akornsys-rdi/high-torque-servo-arm/3d/hand-inmoov/Index3.stl

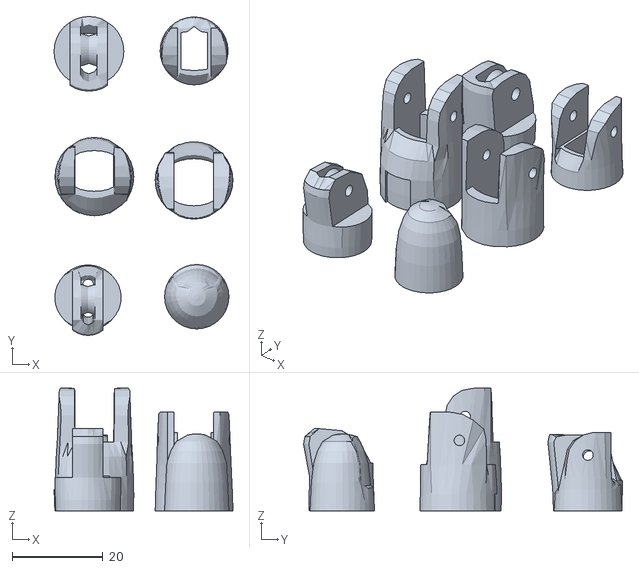
[picture p1: CAD file, 2020-02-25]
3d/hand-inmoov/Index3.stl
39.4 x 70.2 x 27.0
