akornsys-rdi/high-torque-servo-arm/3d/joint_forearm.stl

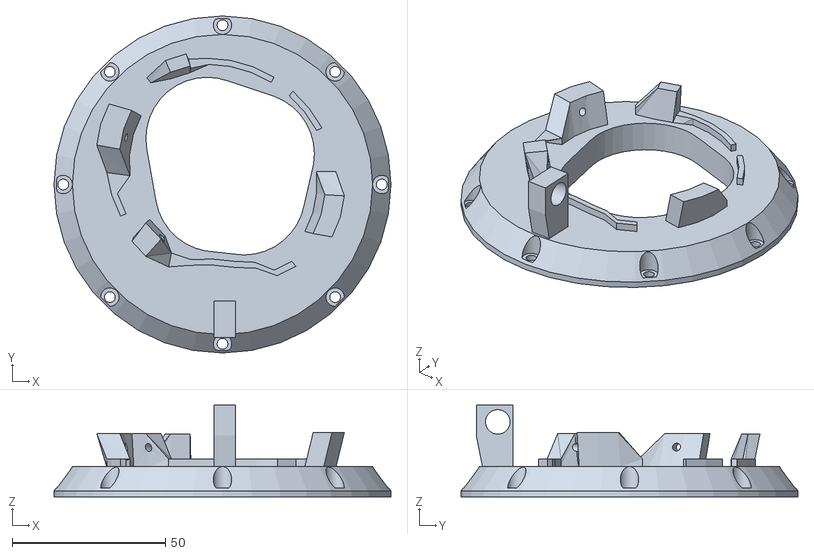
[picture p2: CAD file, 2020-02-25]
3d/joint_forearm.stl
110.0 x 110.0 x 30.0
