akornsys-rdi/high-torque-servo-arm/3d/hand-inmoov/robpart4V3.stl

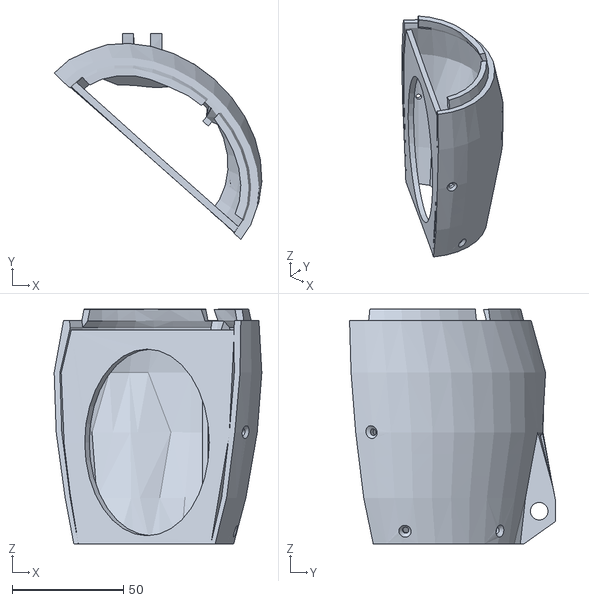
[picture p3: CAD file, 2020-02-25]
3d/hand-inmoov/robpart4V3.stl
93.5 x 92.7 x 105.8
