akornsys-rdi/high-torque-servo-arm/3d/hand-inmoov/robpart2V3.stl

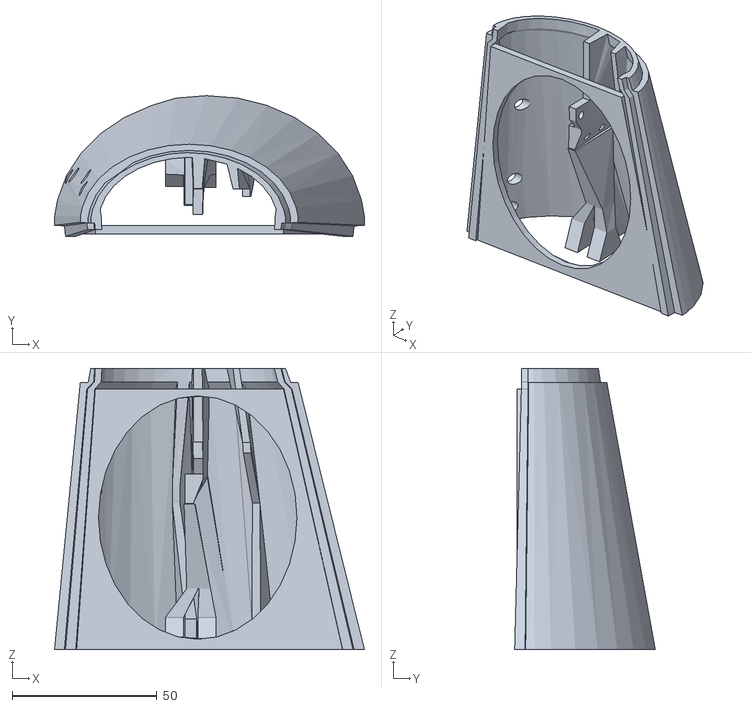
[picture p4: CAD file, 2020-02-25]
3d/hand-inmoov/robpart2V3.stl
107.2 x 48.7 x 97.3
