akornsys-rdi/high-torque-servo-arm/3d/hand-inmoov/WristlargeV4.stl

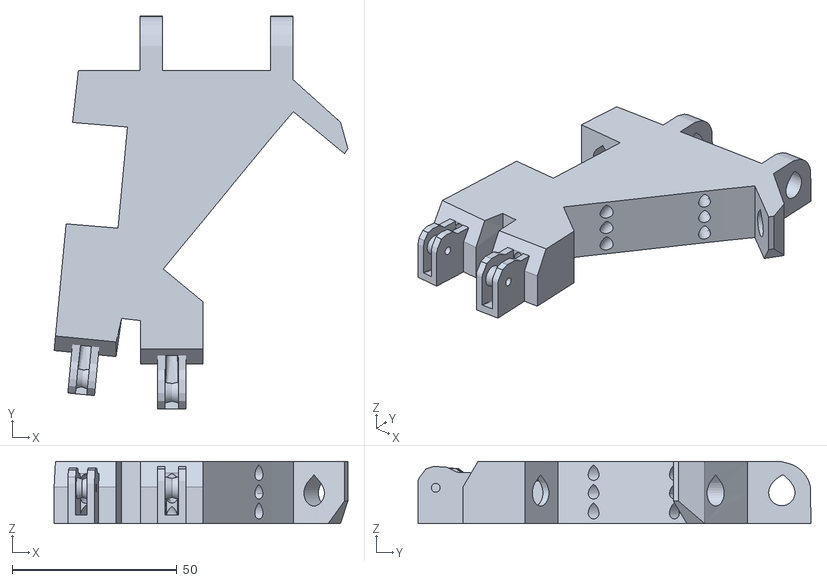
[picture p5: CAD file, 2020-02-25]
3d/hand-inmoov/WristlargeV4.stl
89.2 x 119.4 x 18.9
