akornsys-rdi/high-torque-servo-arm/3d/hand-inmoov/Majeure3.stl

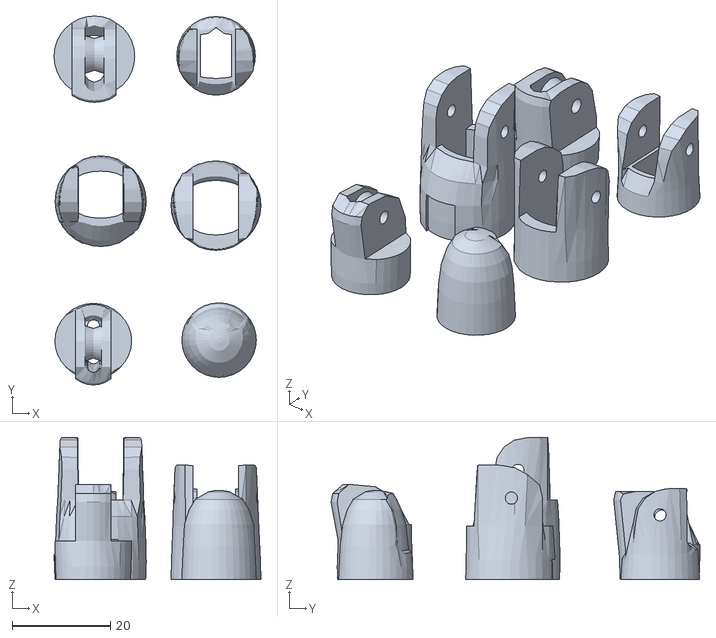
[picture p6: CAD file, 2020-02-25]
3d/hand-inmoov/Majeure3.stl
42.2 x 75.2 x 29.0
