akornsys-rdi/high-torque-servo-arm/3d/hand-inmoov/robpart3V3.stl

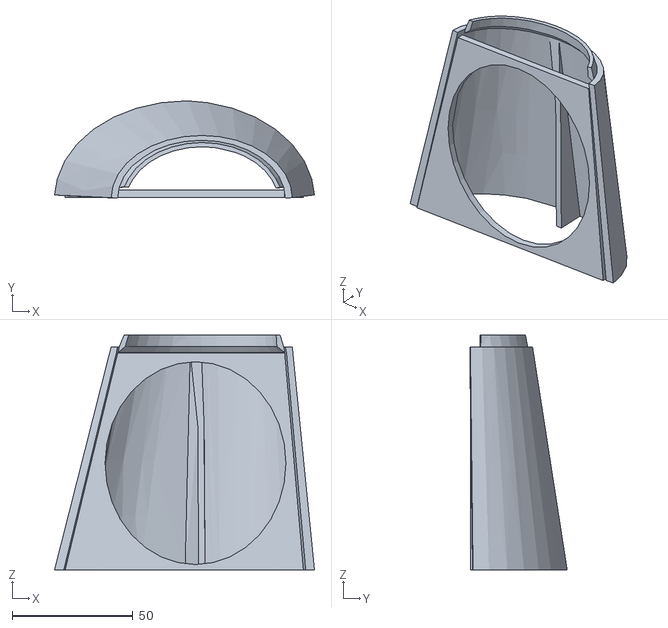
[picture p7: CAD file, 2020-02-25]
3d/hand-inmoov/robpart3V3.stl
107.8 x 40.4 x 97.3
