akornsys-rdi/high-torque-servo-arm/3d/hand-inmoov/ringfinger3.stl

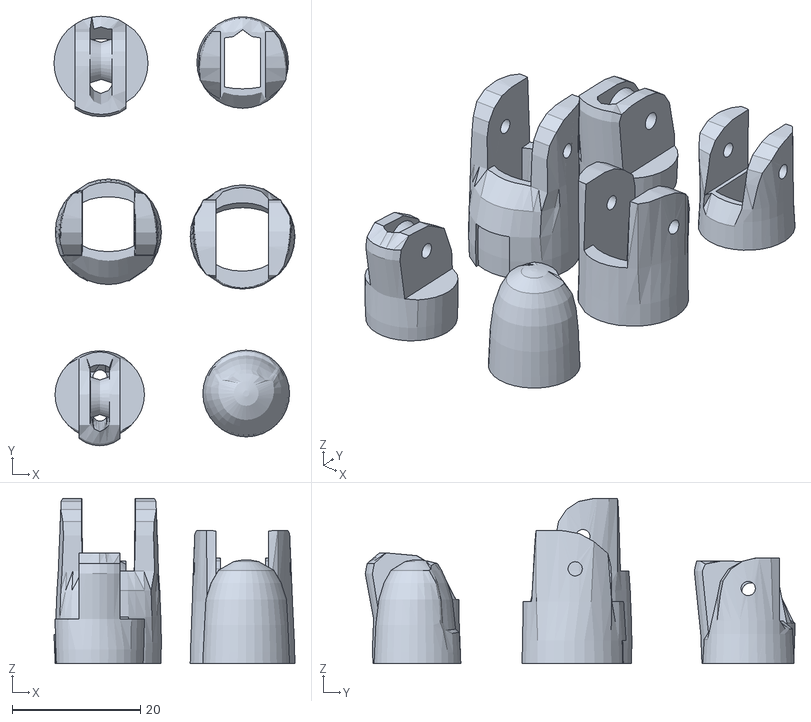
[picture p8: CAD file, 2020-02-25]
3d/hand-inmoov/ringfinger3.stl
37.6 x 67.0 x 25.8
