akornsys-rdi/high-torque-servo-arm/3d/hand-inmoov/elbow-axis-small.stl

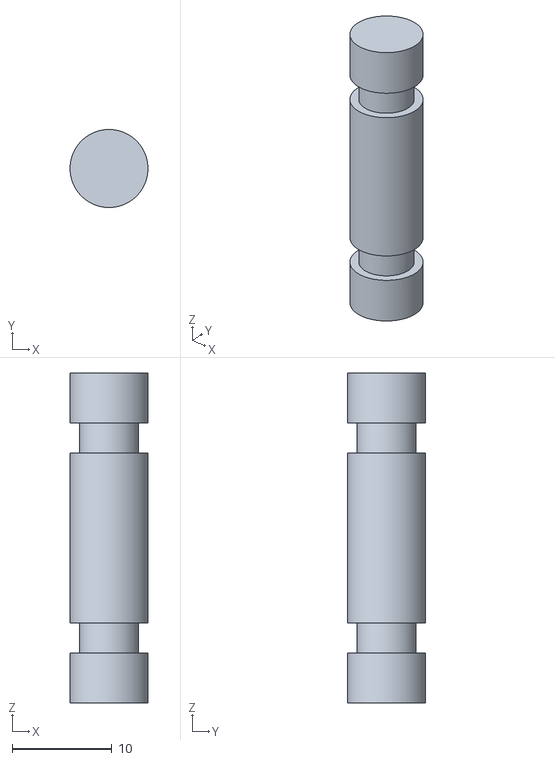
[picture p9: CAD file, 2020-02-25]
3d/hand-inmoov/elbow-axis-small.stl
7.80 x 7.80 x 33.0
