akornsys-rdi/high-torque-servo-arm/3d/hand-inmoov/elbow-axis-clip.stl

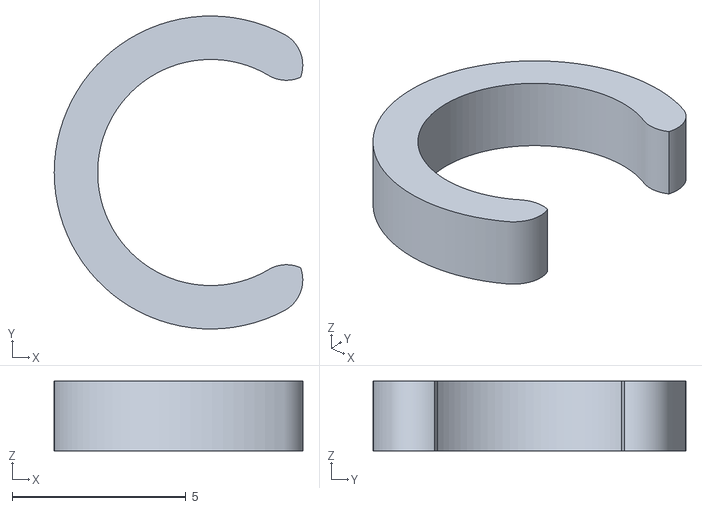
[picture p10: CAD file, 2020-02-25]
3d/hand-inmoov/elbow-axis-clip.stl
7.15 x 9.00 x 2.00
