akornsys-rdi/high-torque-servo-arm/3d/hand-inmoov/WristsmallV3.stl

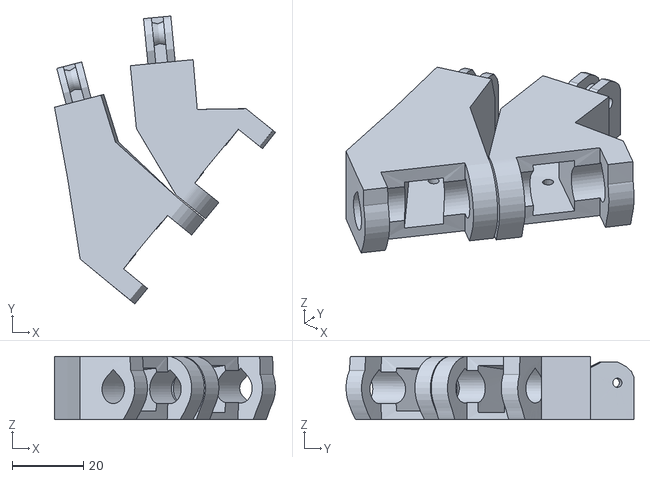
[picture p11: CAD file, 2020-02-25]
3d/hand-inmoov/WristsmallV3.stl
62.0 x 80.8 x 17.7
