akornsys-rdi/high-torque-servo-arm/3d/hand-inmoov/thumb5.stl

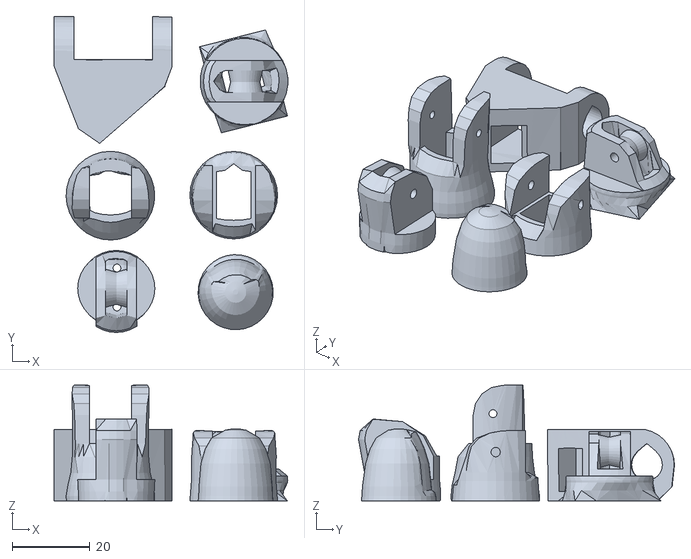
[picture p12: CAD file, 2020-02-25]
3d/hand-inmoov/thumb5.stl
60.1 x 81.2 x 29.8
