akornsys-rdi/high-torque-servo-arm/3d/hand-inmoov/robpart5V3.stl

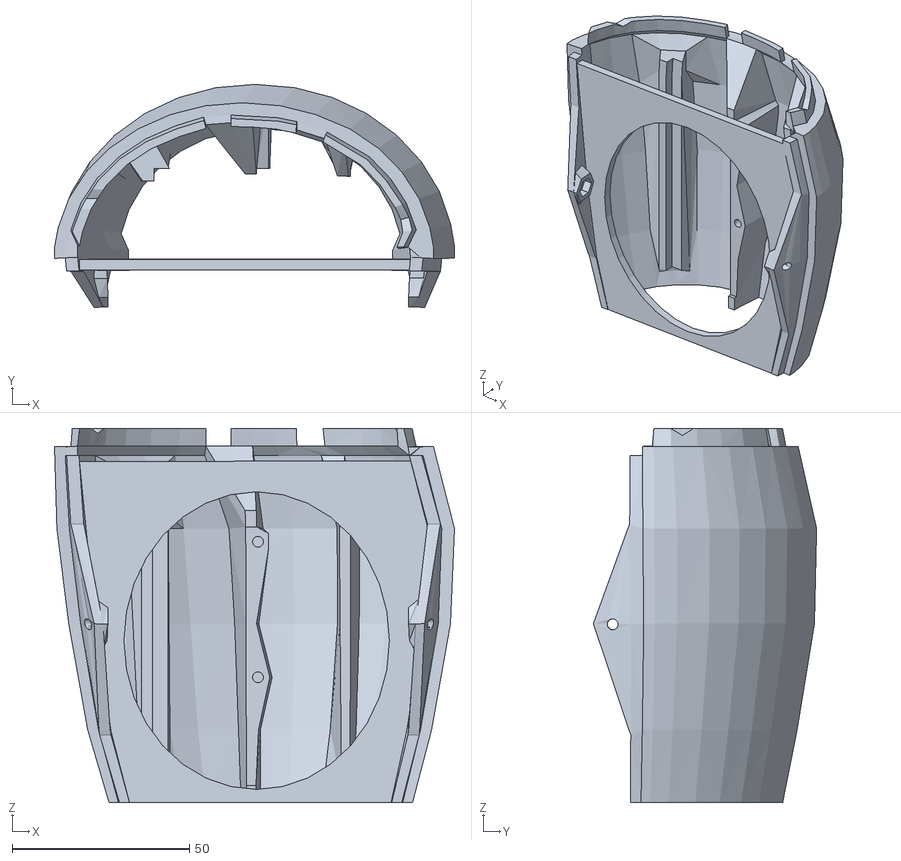
[picture p13: CAD file, 2020-02-25]
3d/hand-inmoov/robpart5V3.stl
113.0 x 63.1 x 105.7
