akornsys-rdi/high-torque-servo-arm/3d/hand-inmoov/robpart1V2.stl

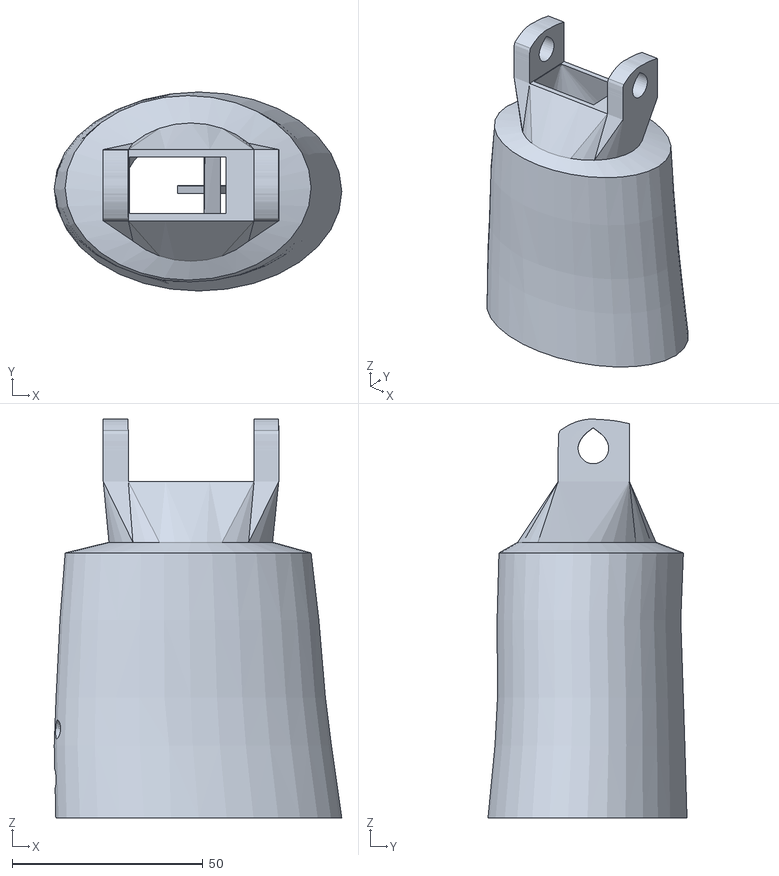
[picture p14: CAD file, 2020-02-25]
3d/hand-inmoov/robpart1V2.stl
75.5 x 52.2 x 104.7
