akornsys-rdi/high-torque-servo-arm/3d/hand-inmoov/robcap3V1.stl

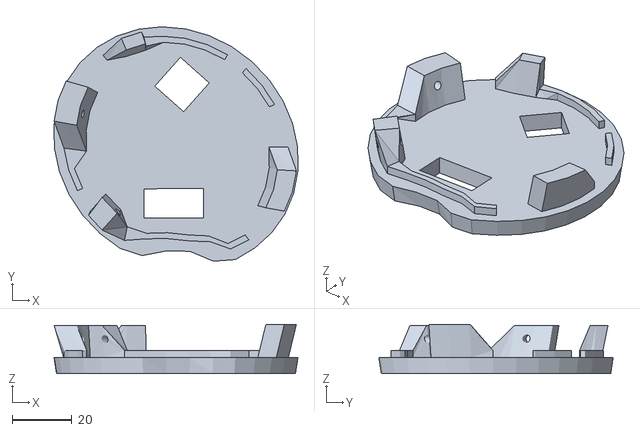
[picture p15: CAD file, 2020-02-25]
3d/hand-inmoov/robcap3V1.stl
81.4 x 78.2 x 16.4
