akornsys-rdi/high-torque-servo-arm/3d/hand-inmoov/Auriculaire3.stl

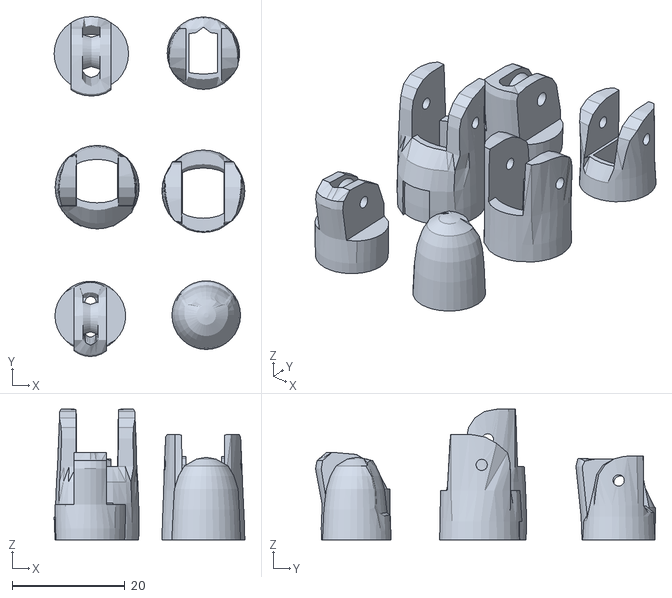
[picture p16: CAD file, 2020-02-25]
3d/hand-inmoov/Auriculaire3.stl
33.8 x 60.3 x 23.2
