akornsys-rdi/high-torque-servo-arm/3d/hand-inmoov/Bolt_entretoise7.stl

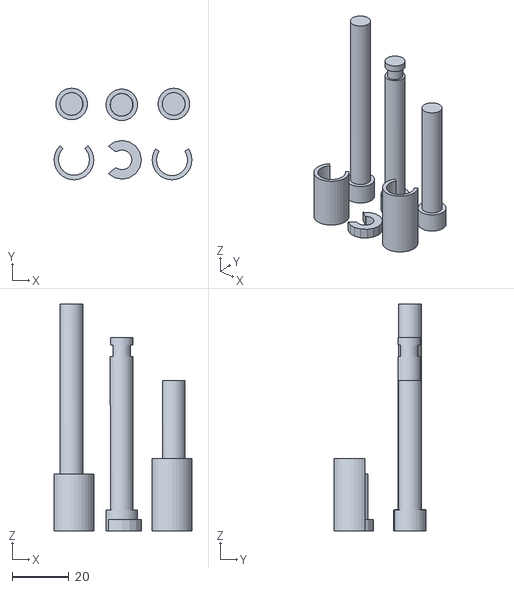
[picture p17: CAD file, 2020-02-25]
3d/hand-inmoov/Bolt_entretoise7.stl
48.5 x 32.3 x 79.9
