akornsys-rdi/high-torque-servo-arm/brd/main/out/high-torque-servo-arm-main.pdf

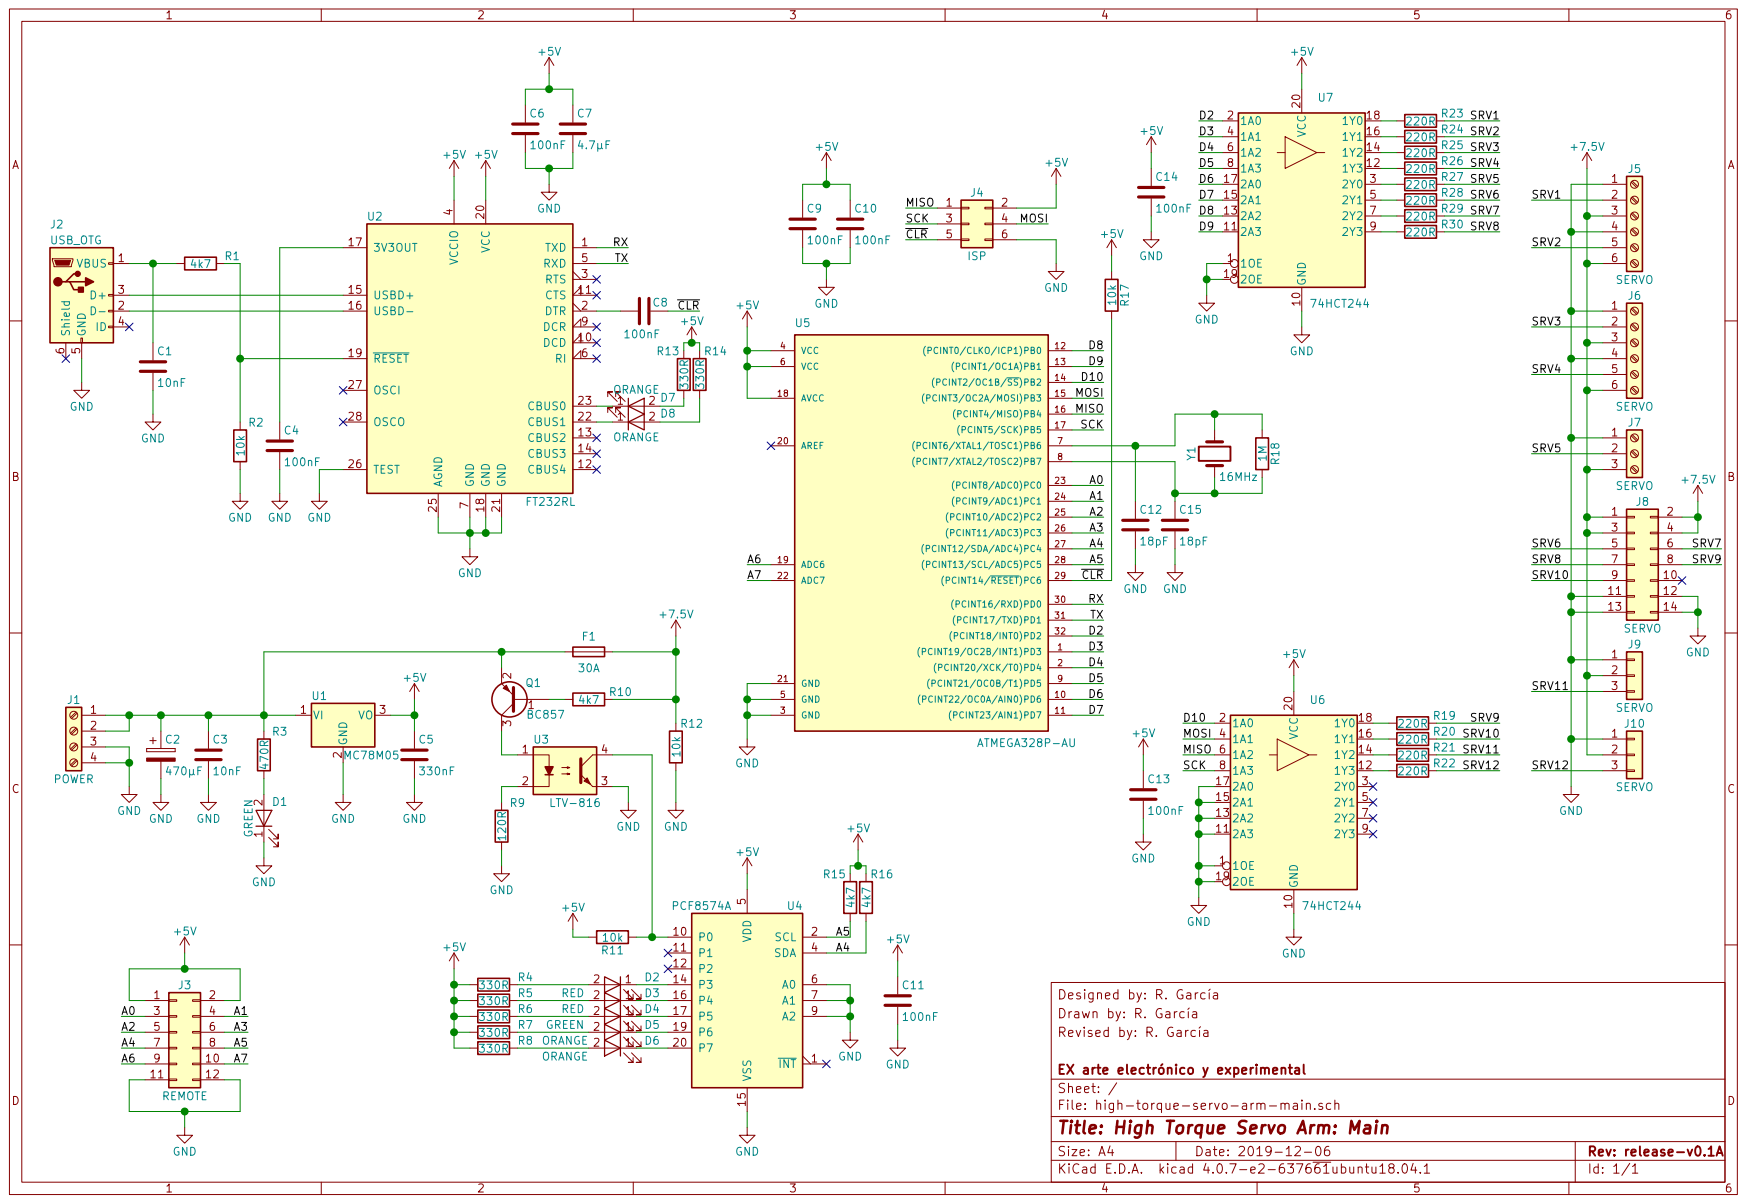
[picture p18: page 1]
