akornsys-rdi/high-torque-servo-arm/brd/microservo/out/high-torque-servo-arm-microservo.pdf

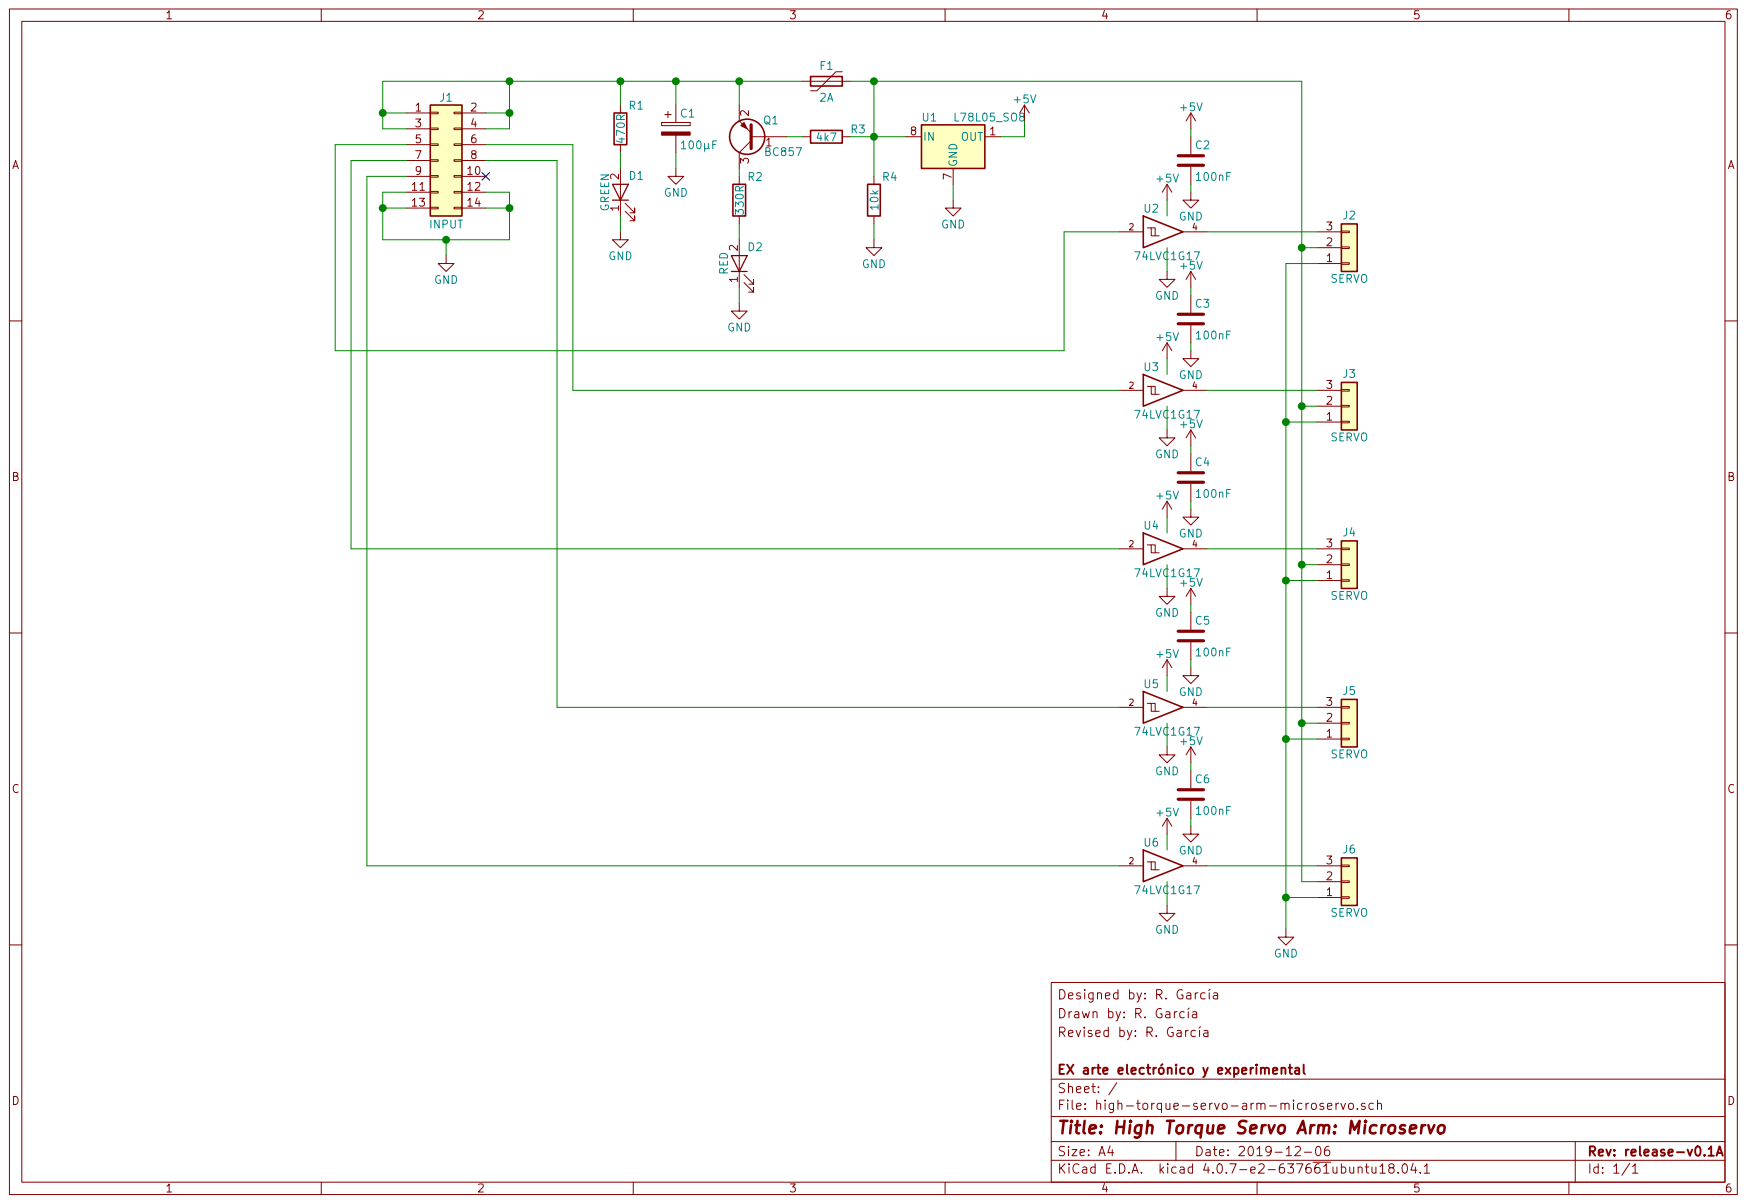
[picture p19: page 1]
