akornsys-rdi/high-torque-servo-arm/brd/microservo/out/high-torque-servo-arm-microservo_pcb.pdf

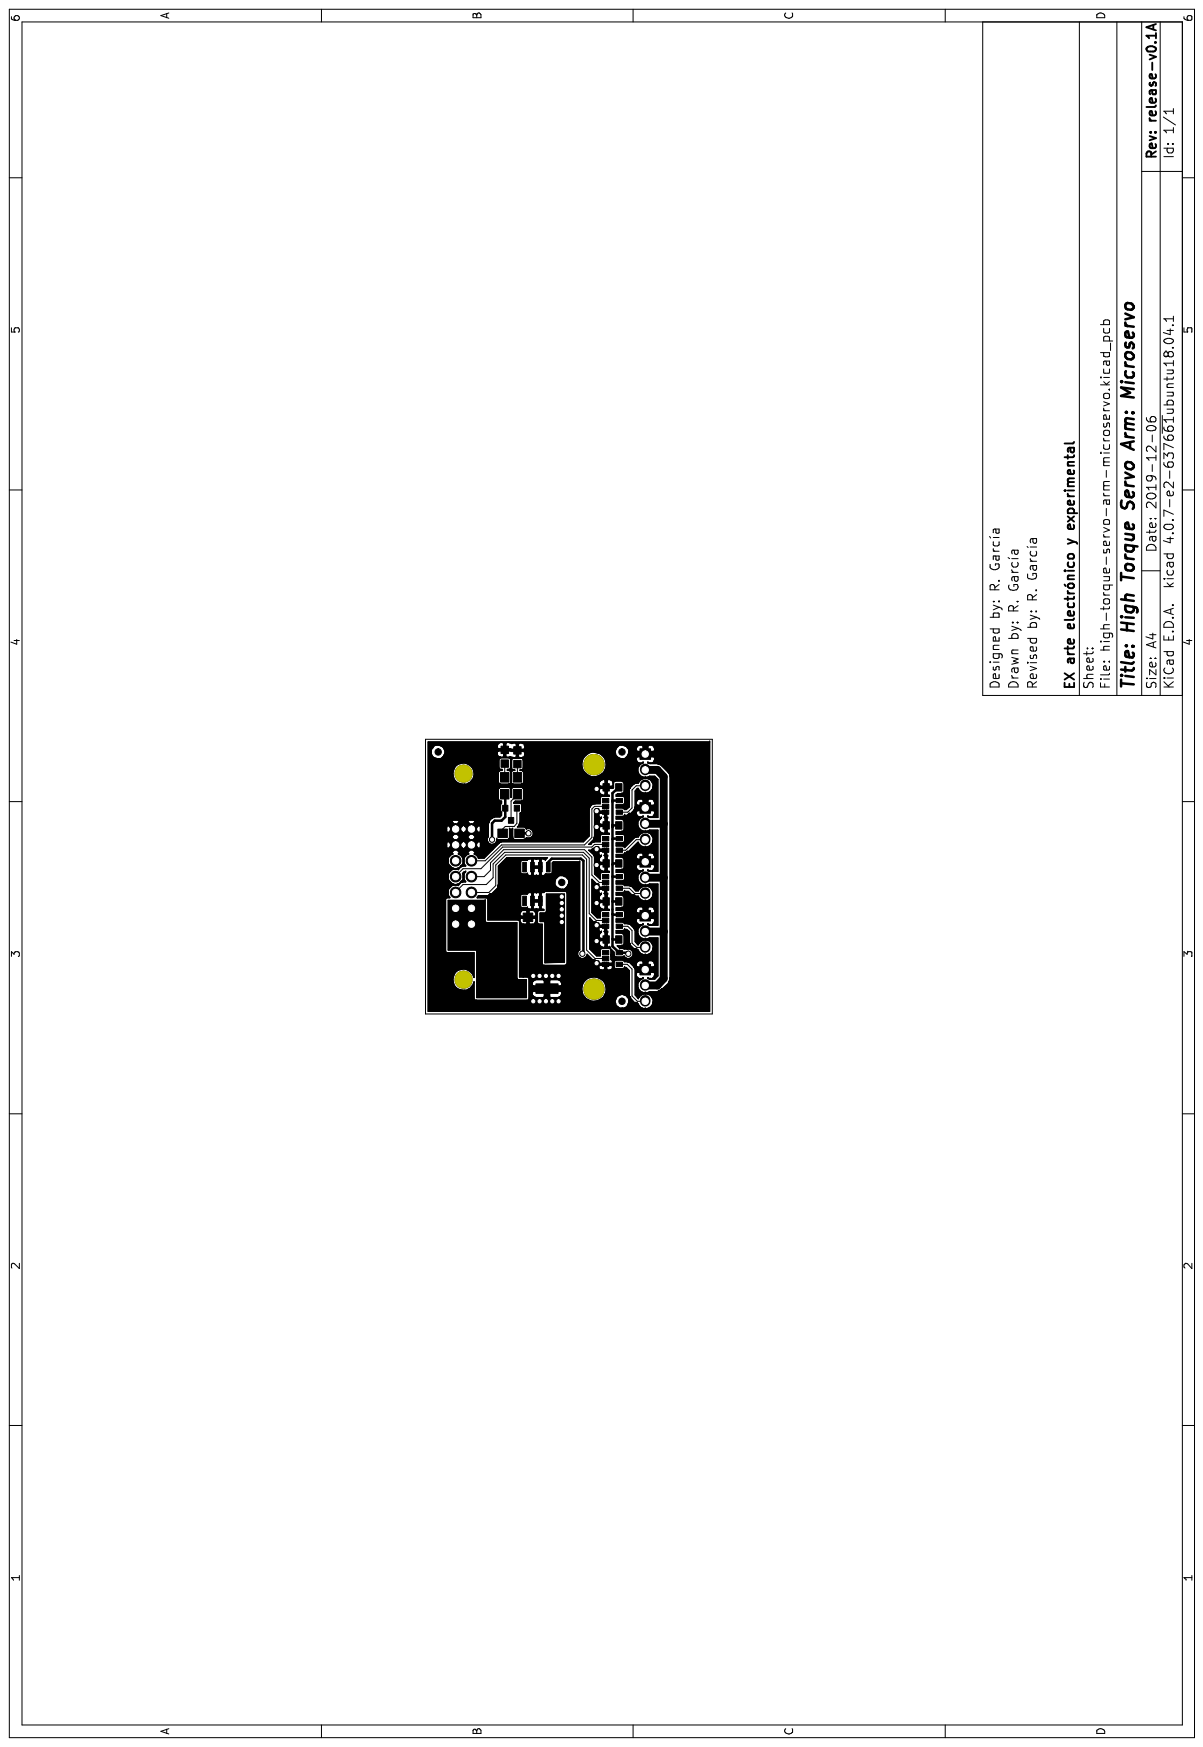
[picture p20: page 1]

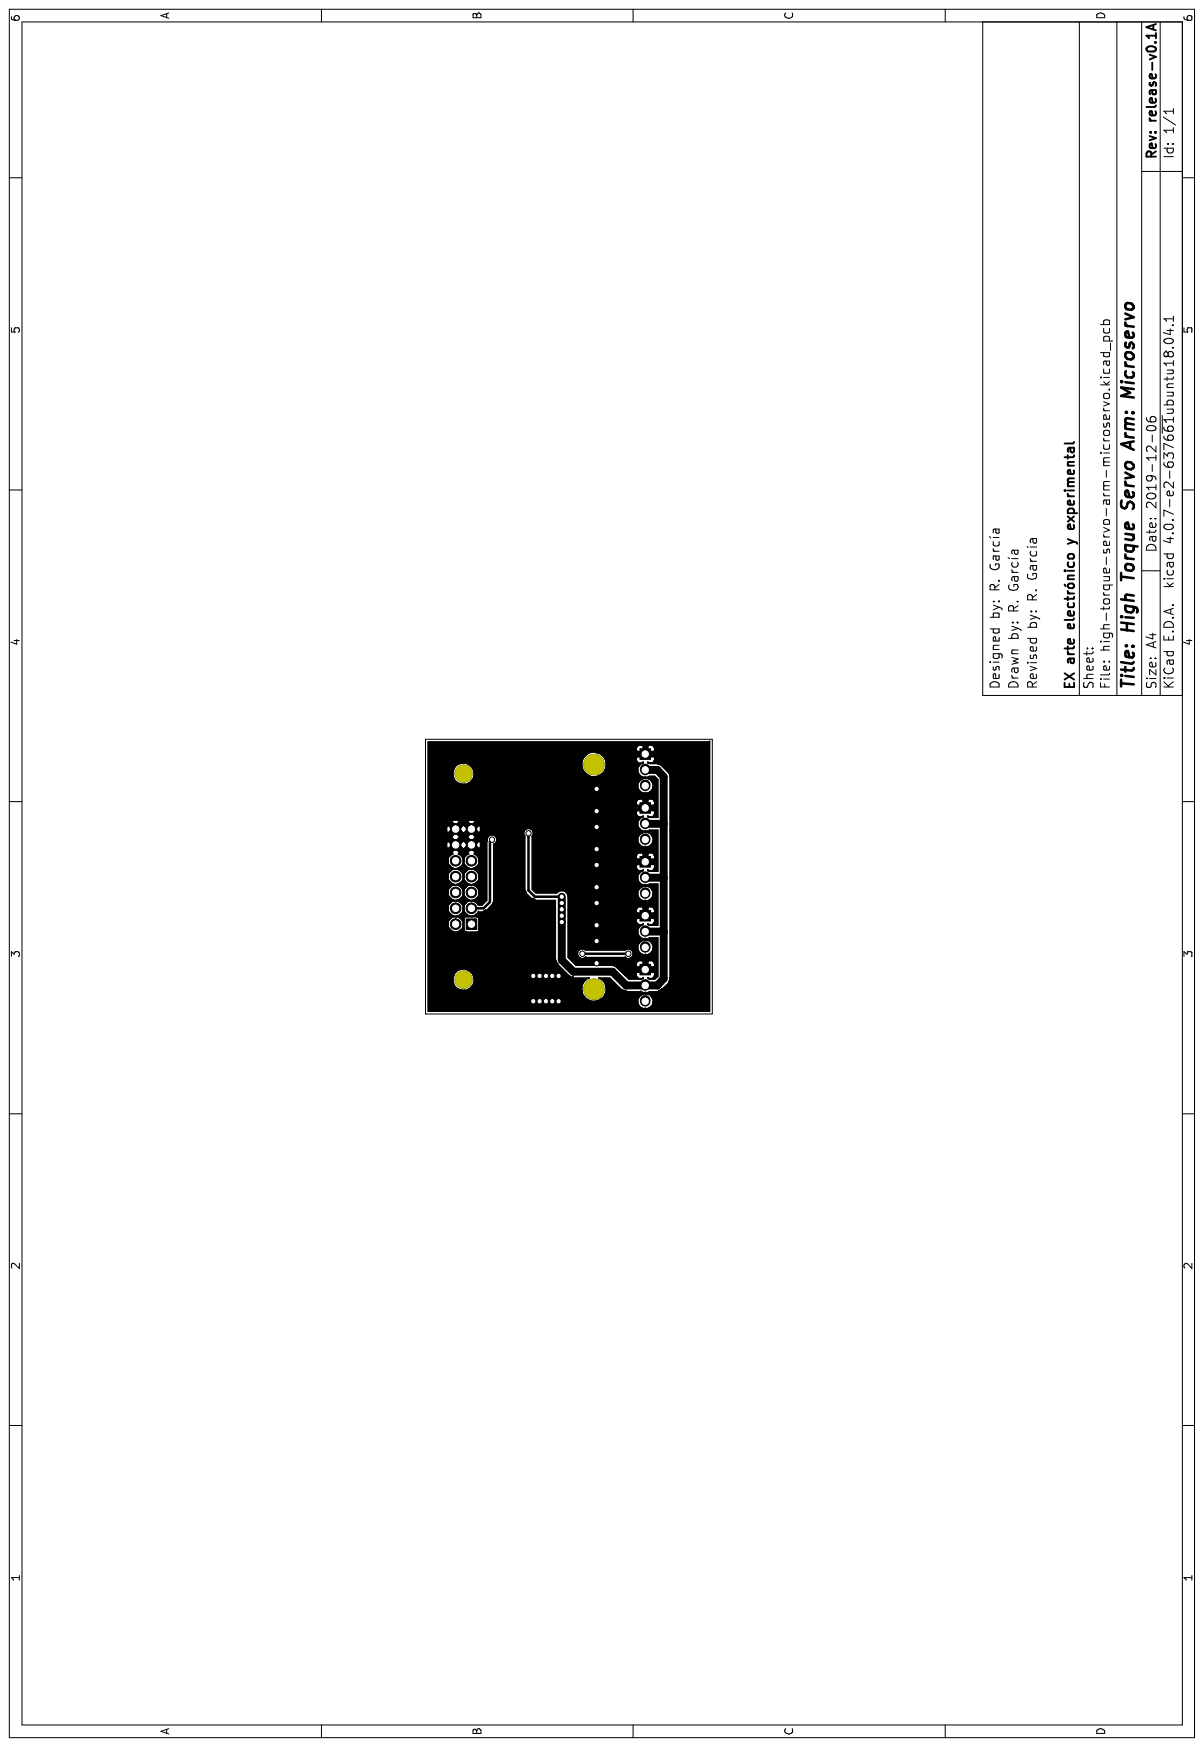
[picture p21: page 2]

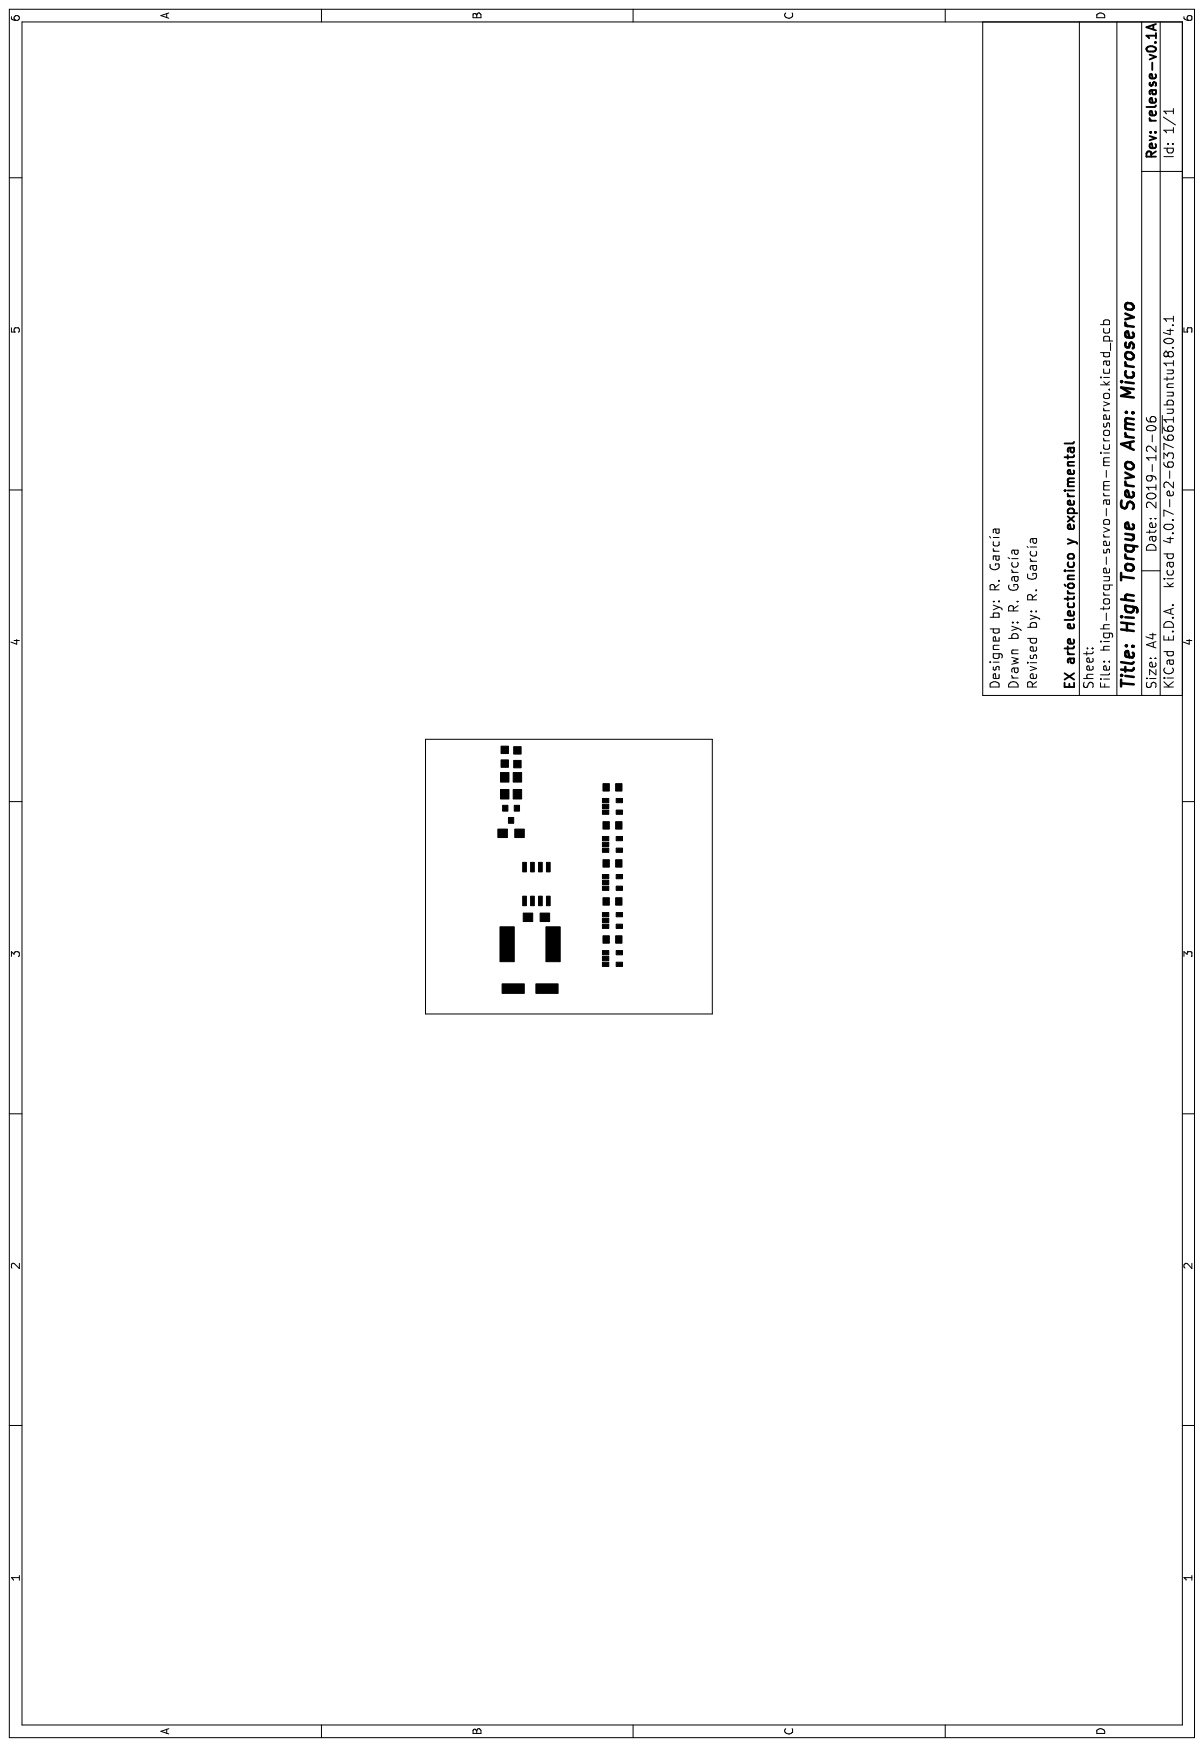
[picture p22: page 3]

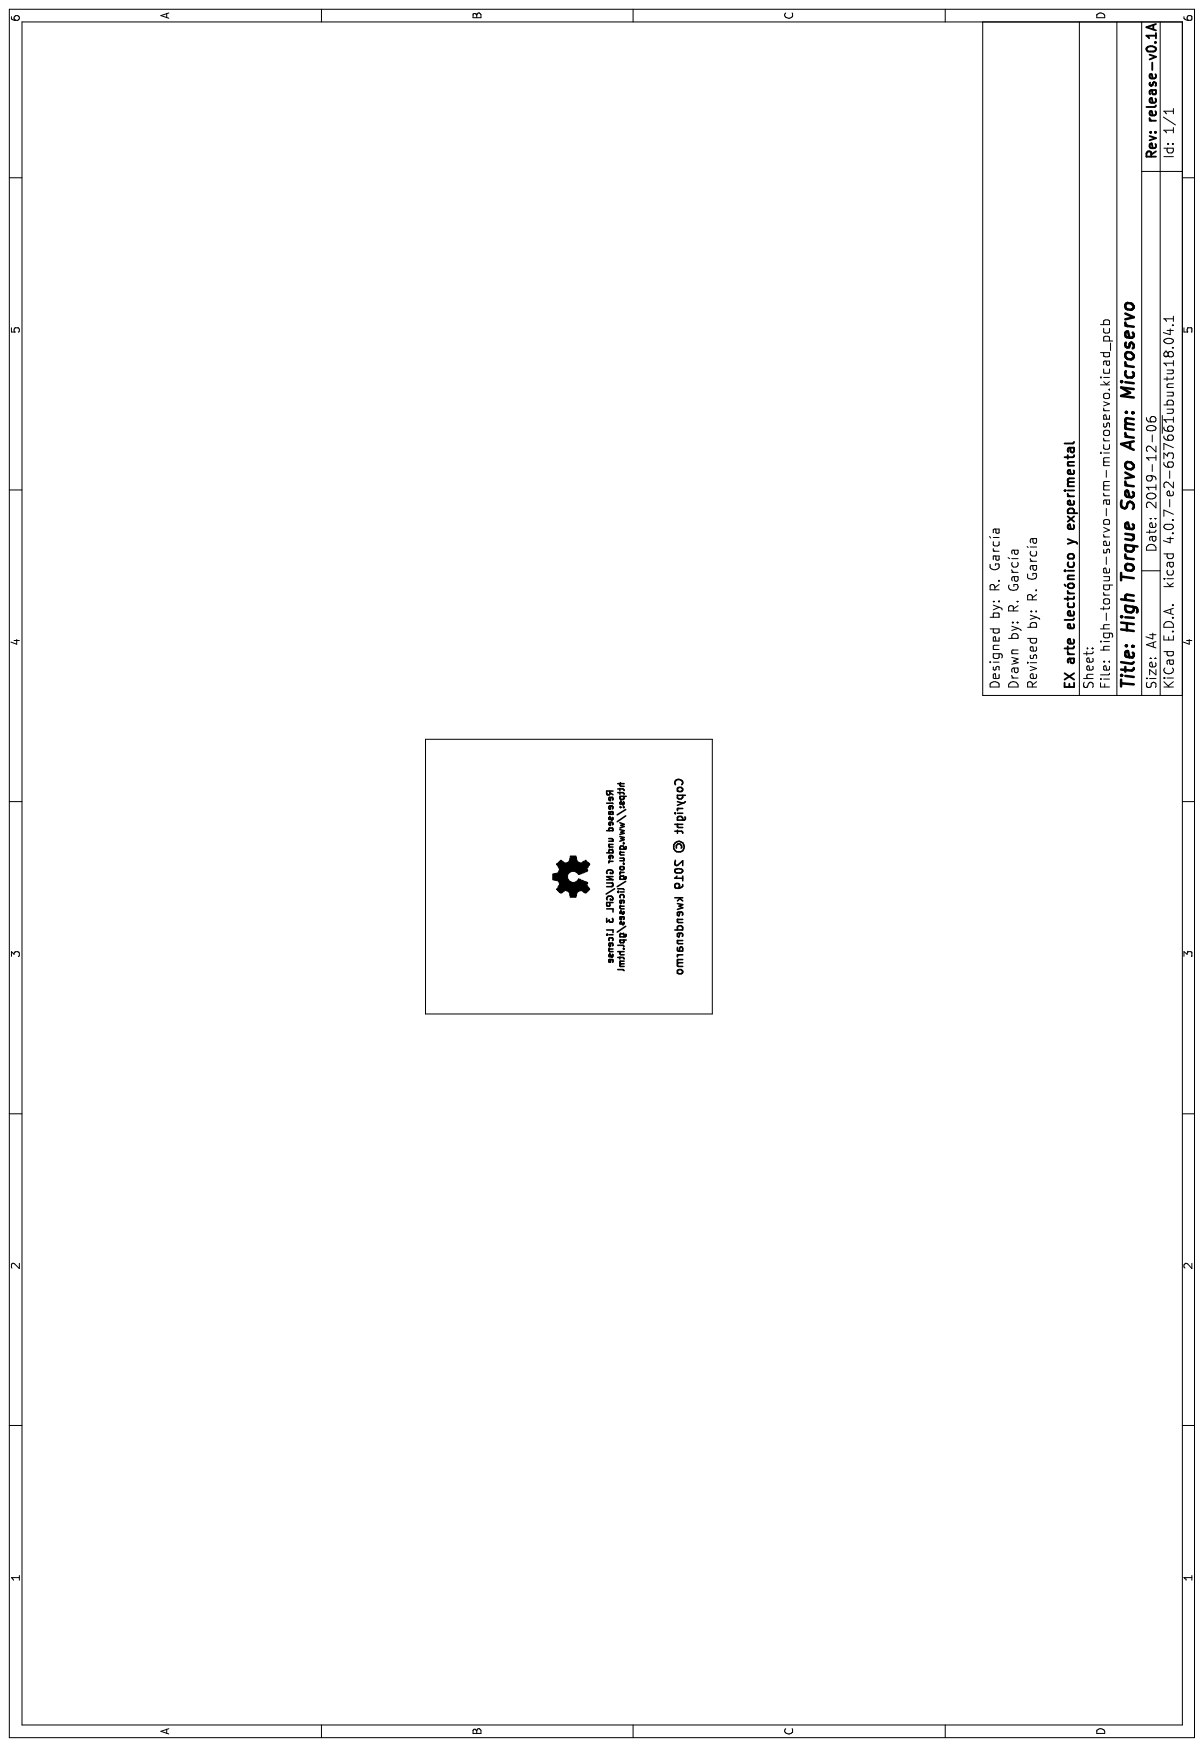
[picture p23: page 4]

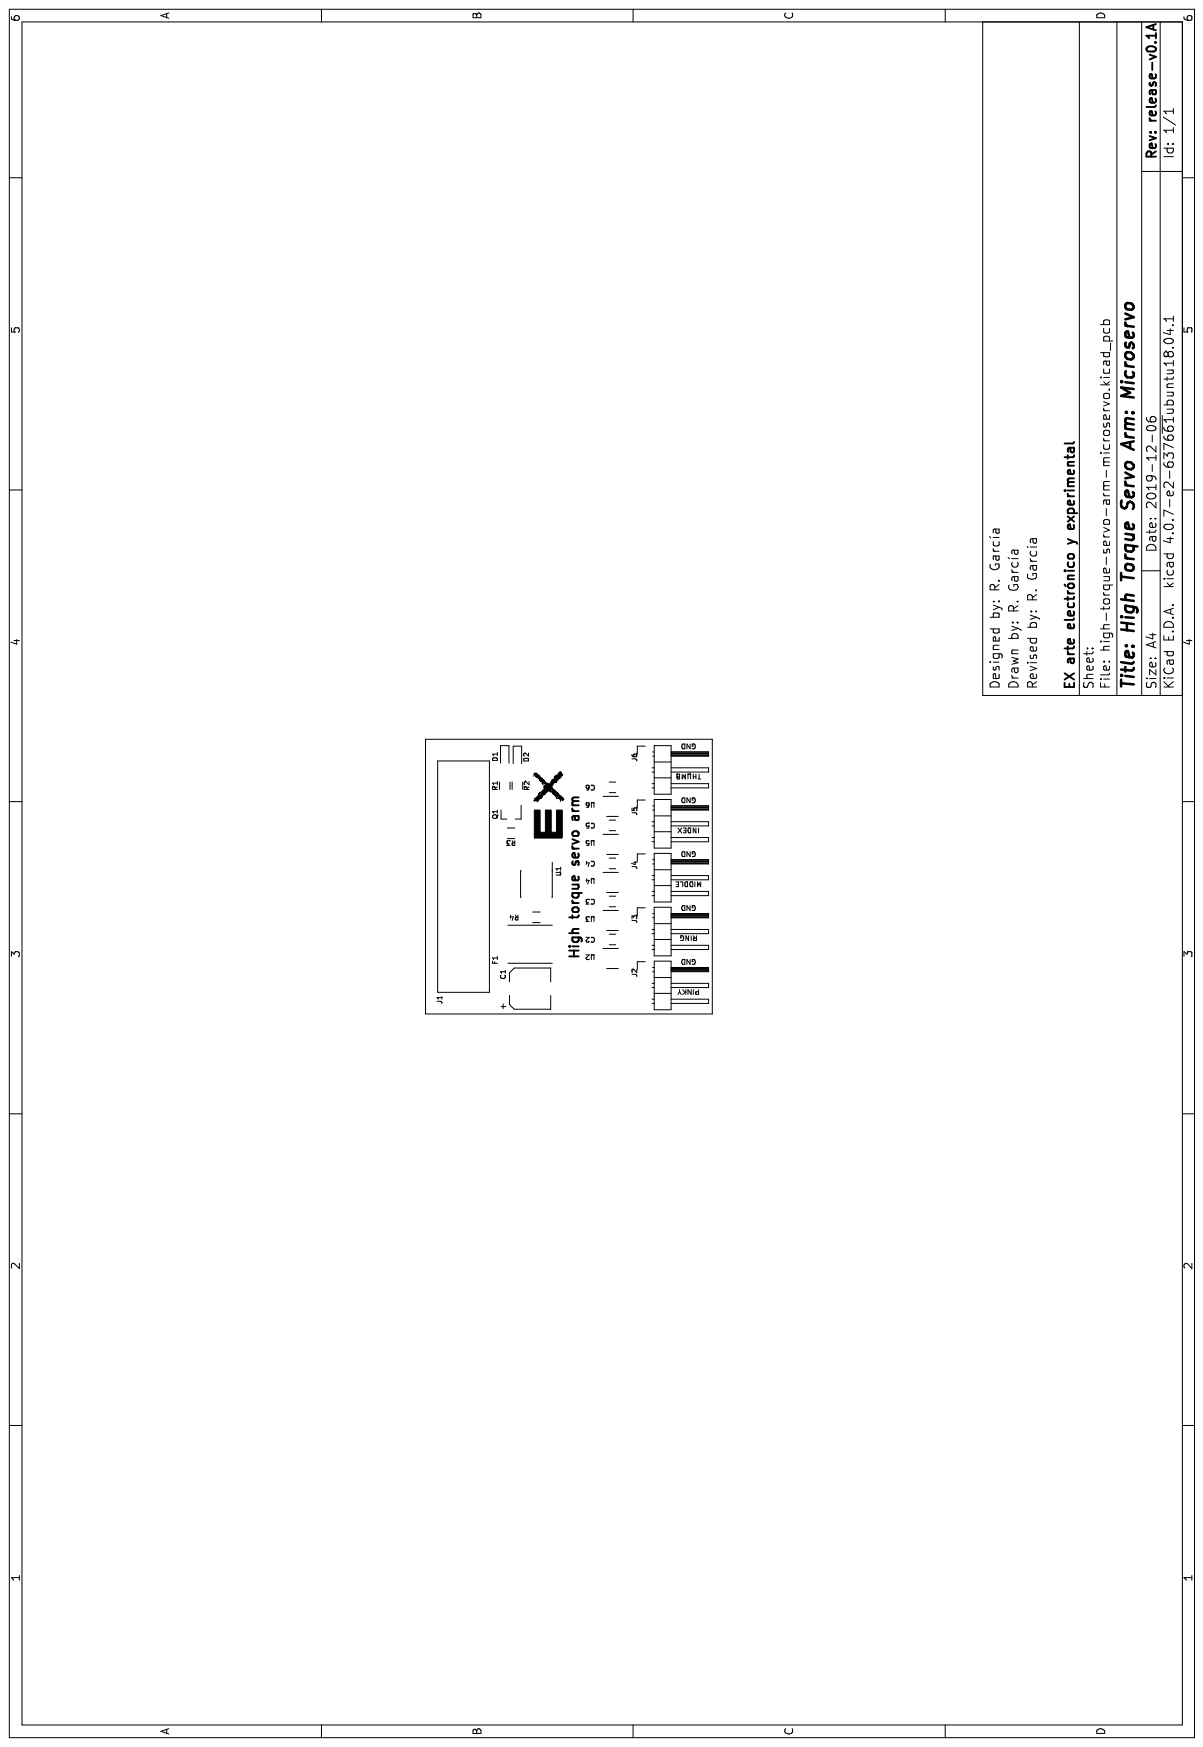
[picture p24: page 5]

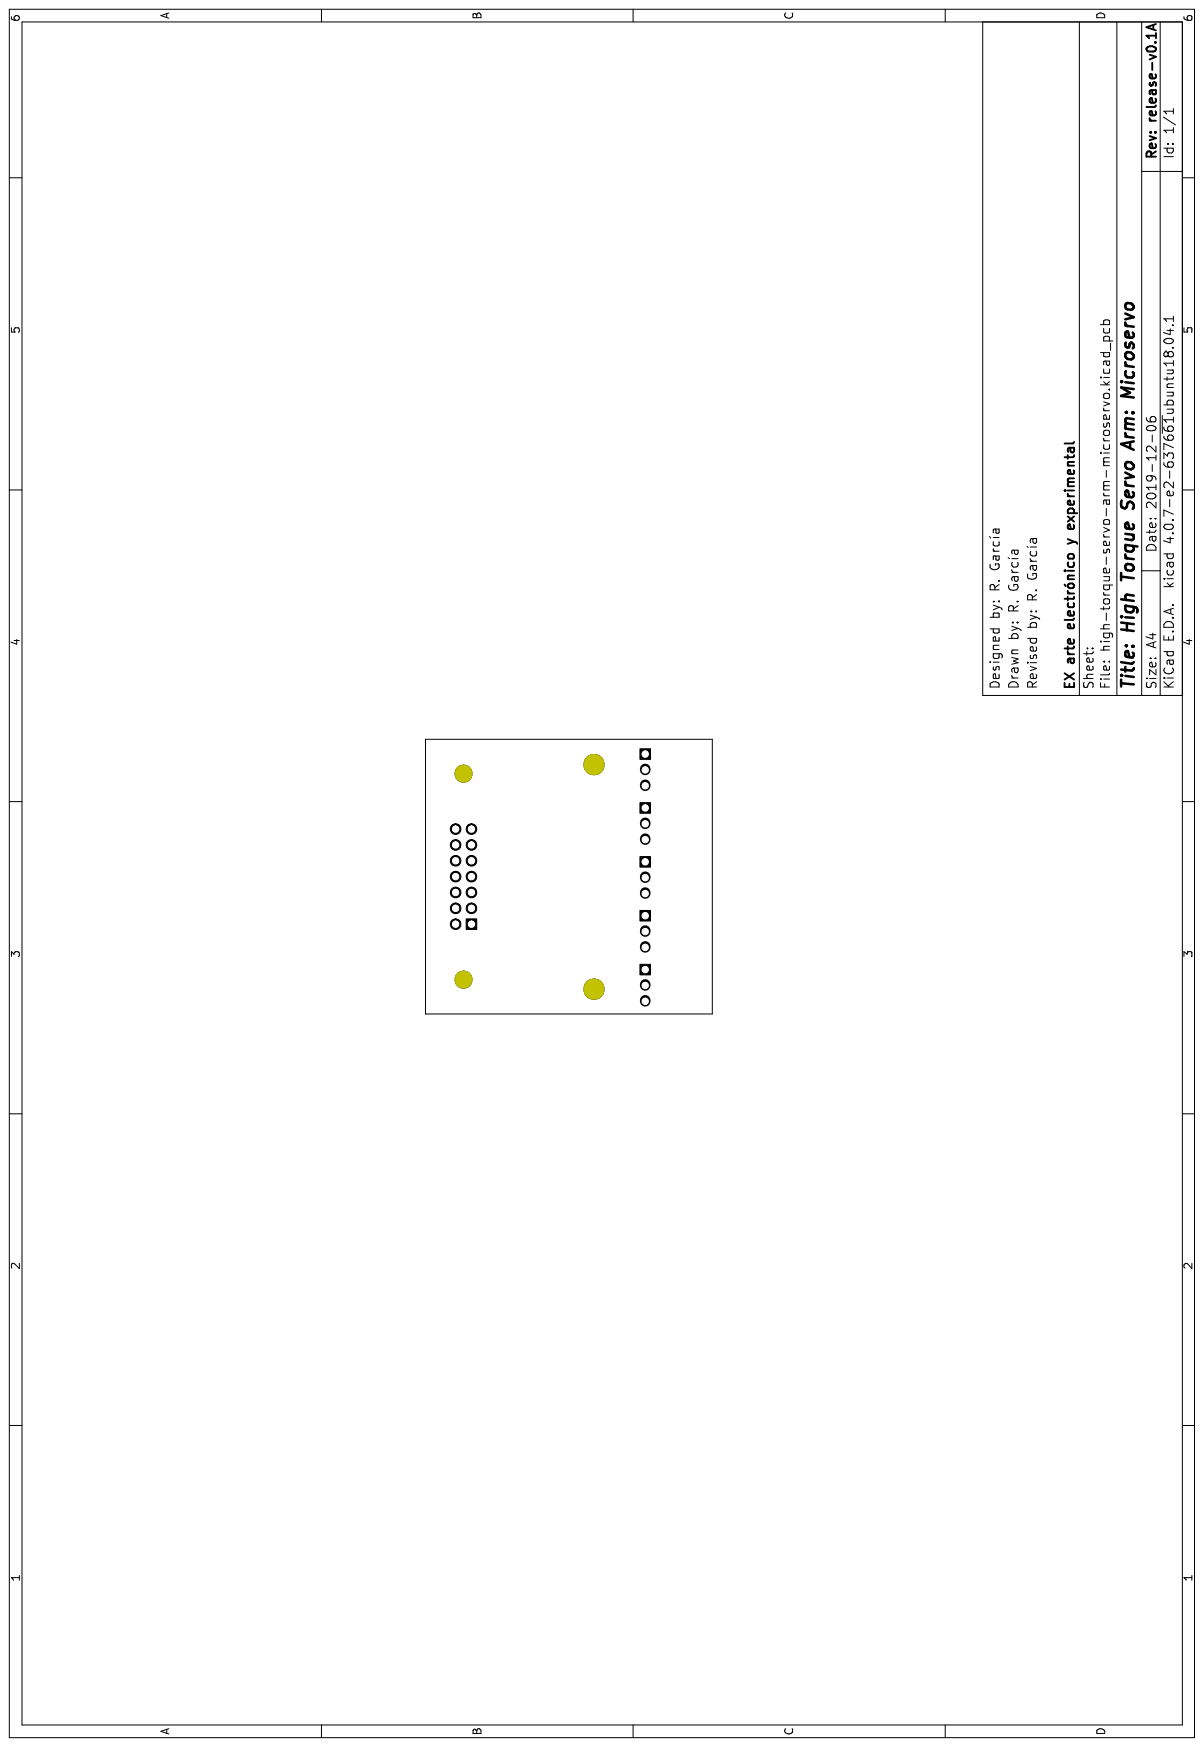
[picture p25: page 6]

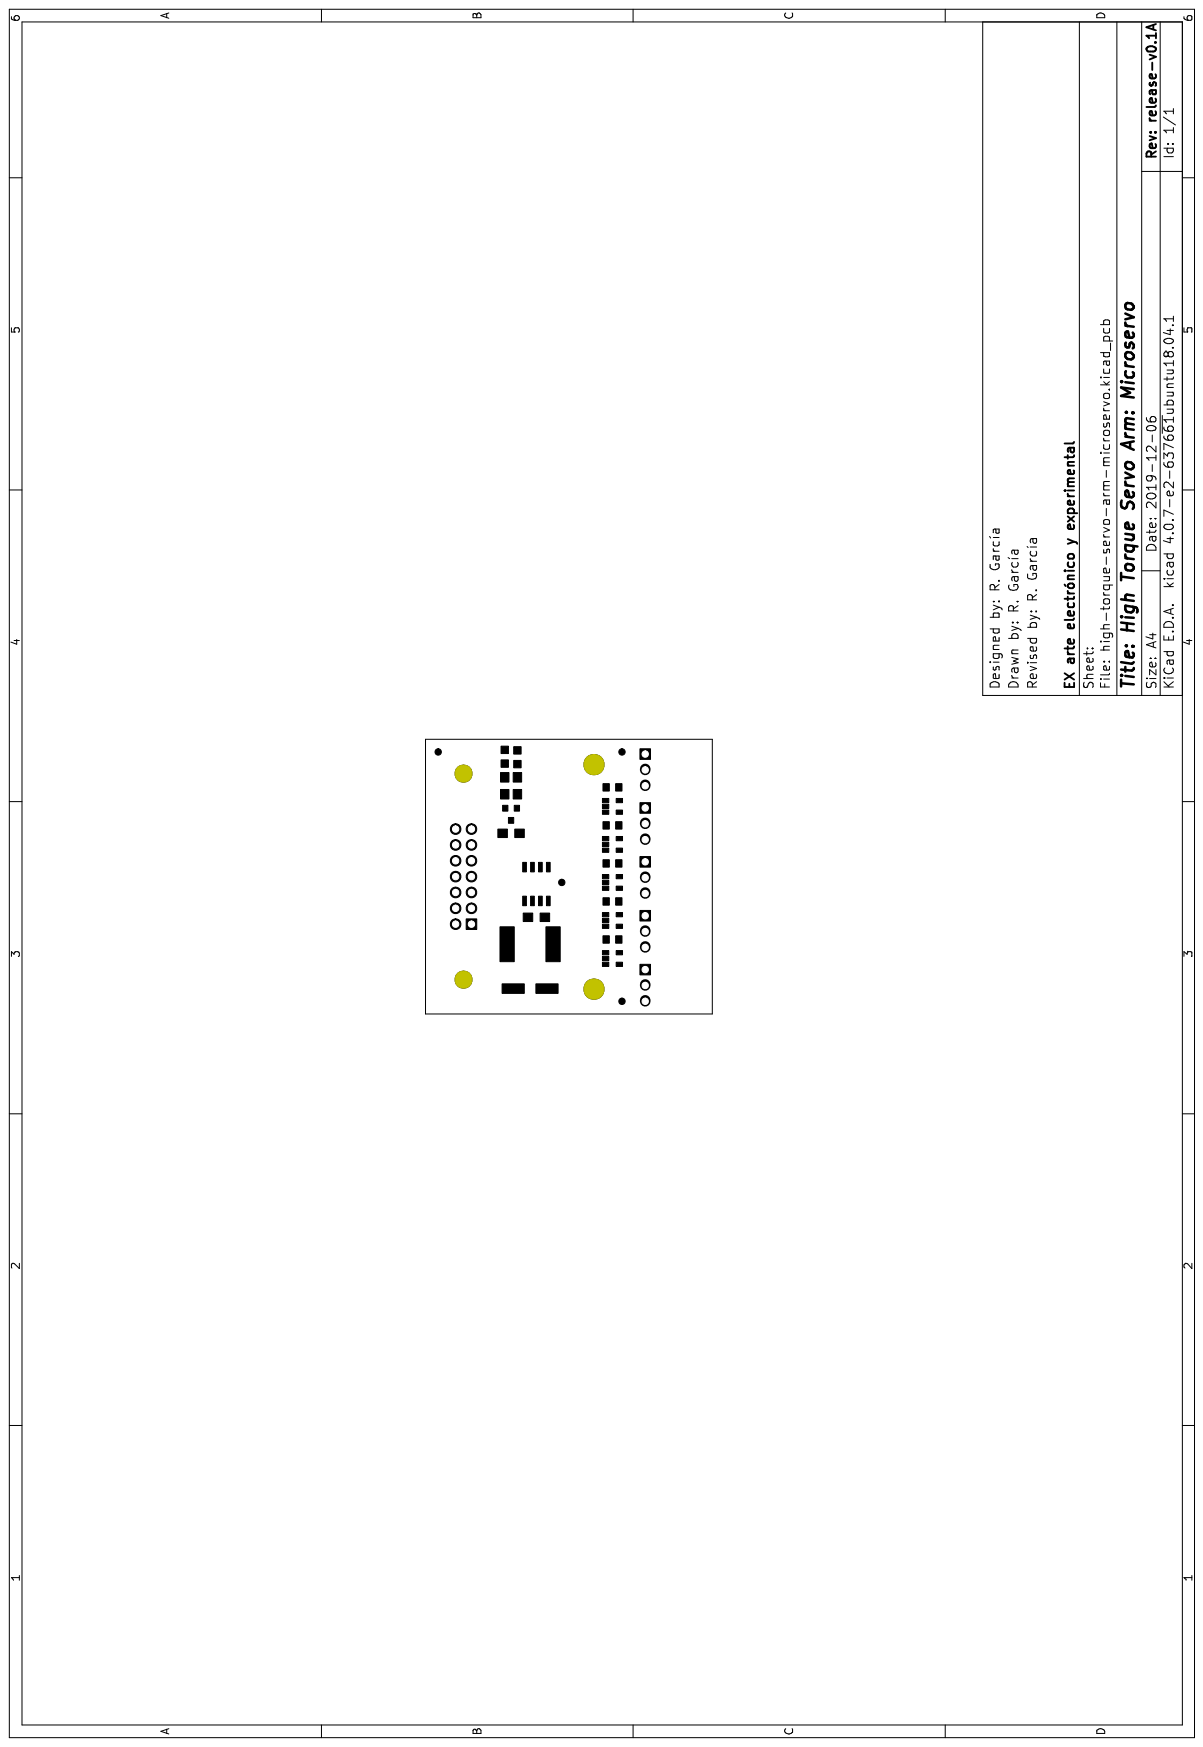
[picture p26: page 7]

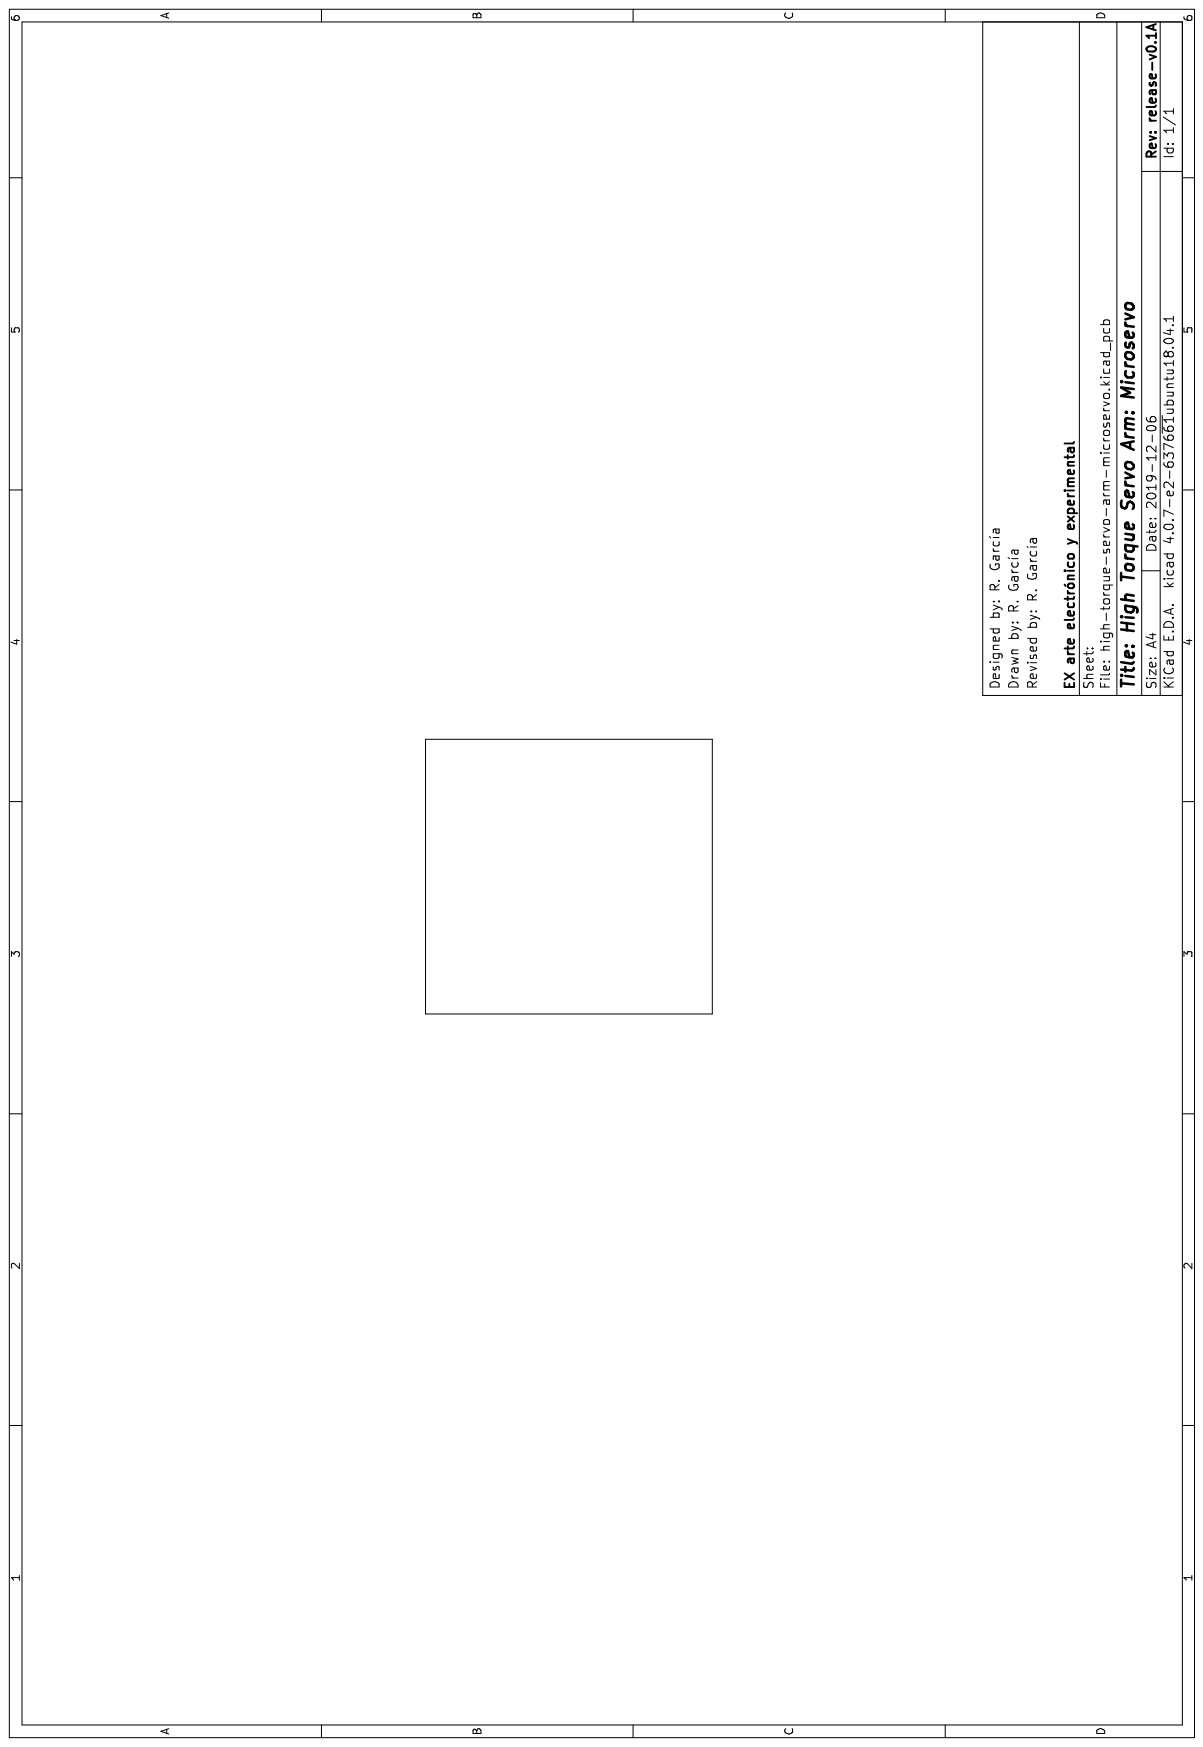
[picture p27: page 8]

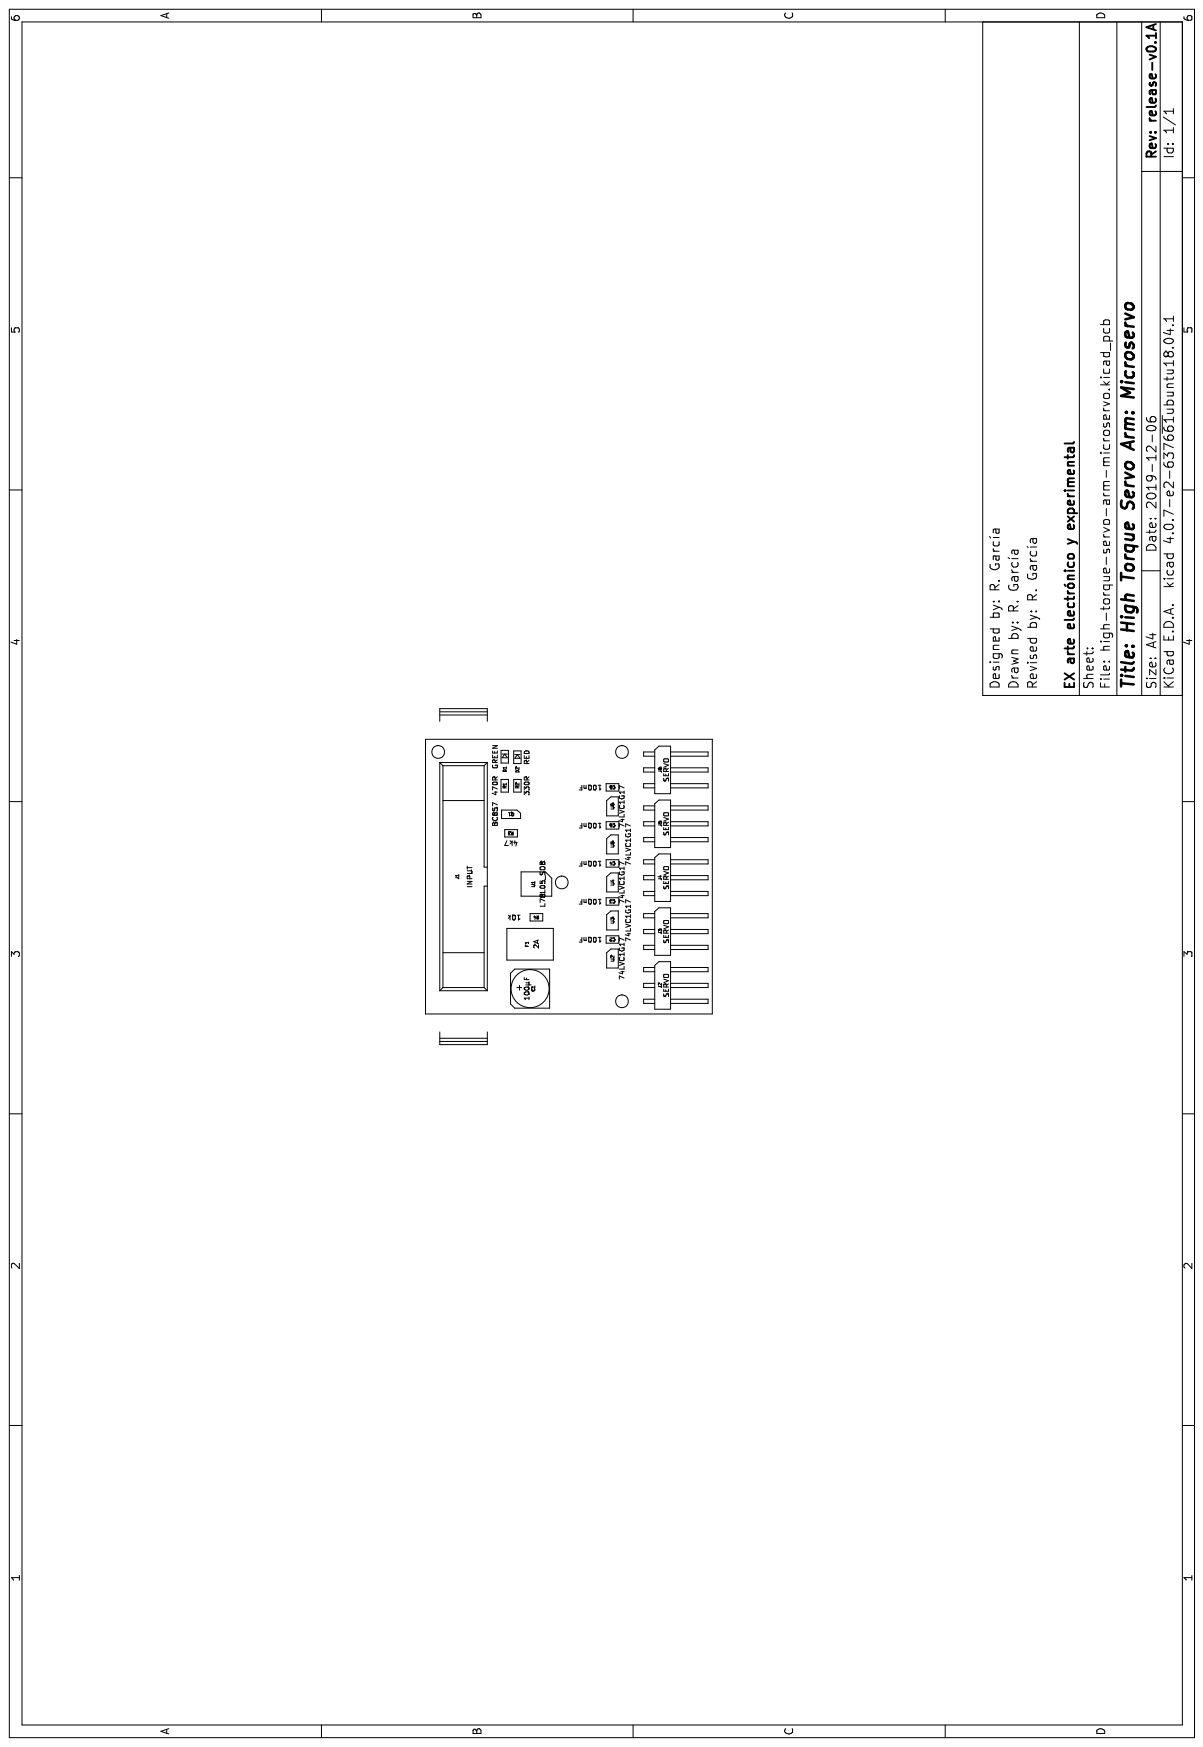
[picture p28: page 9]
