akornsys-rdi/high-torque-servo-arm/brd/servo/out/high-torque-servo-arm-servo.pdf

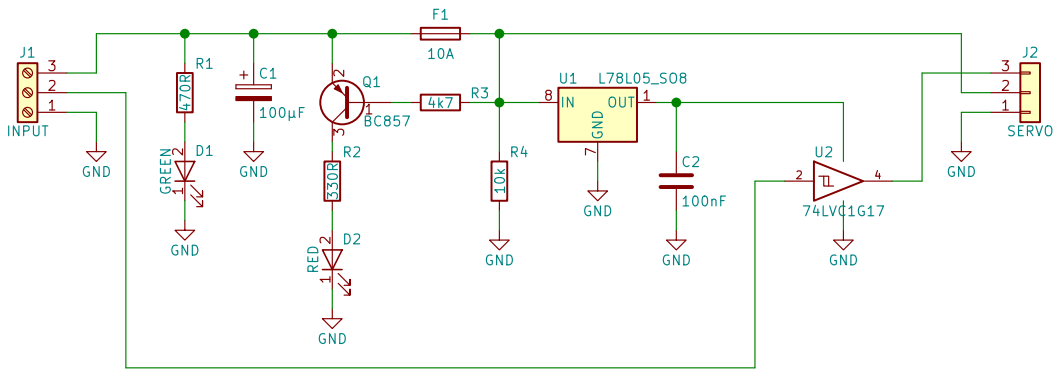
[picture p29: page 1]
