akornsys-rdi/high-torque-servo-arm/brd/main/high-torque-servo-arm-main.kicad_pcb

## KiCad design brd/main/high-torque-servo-arm-main.kicad_pcb (2020-02-25)

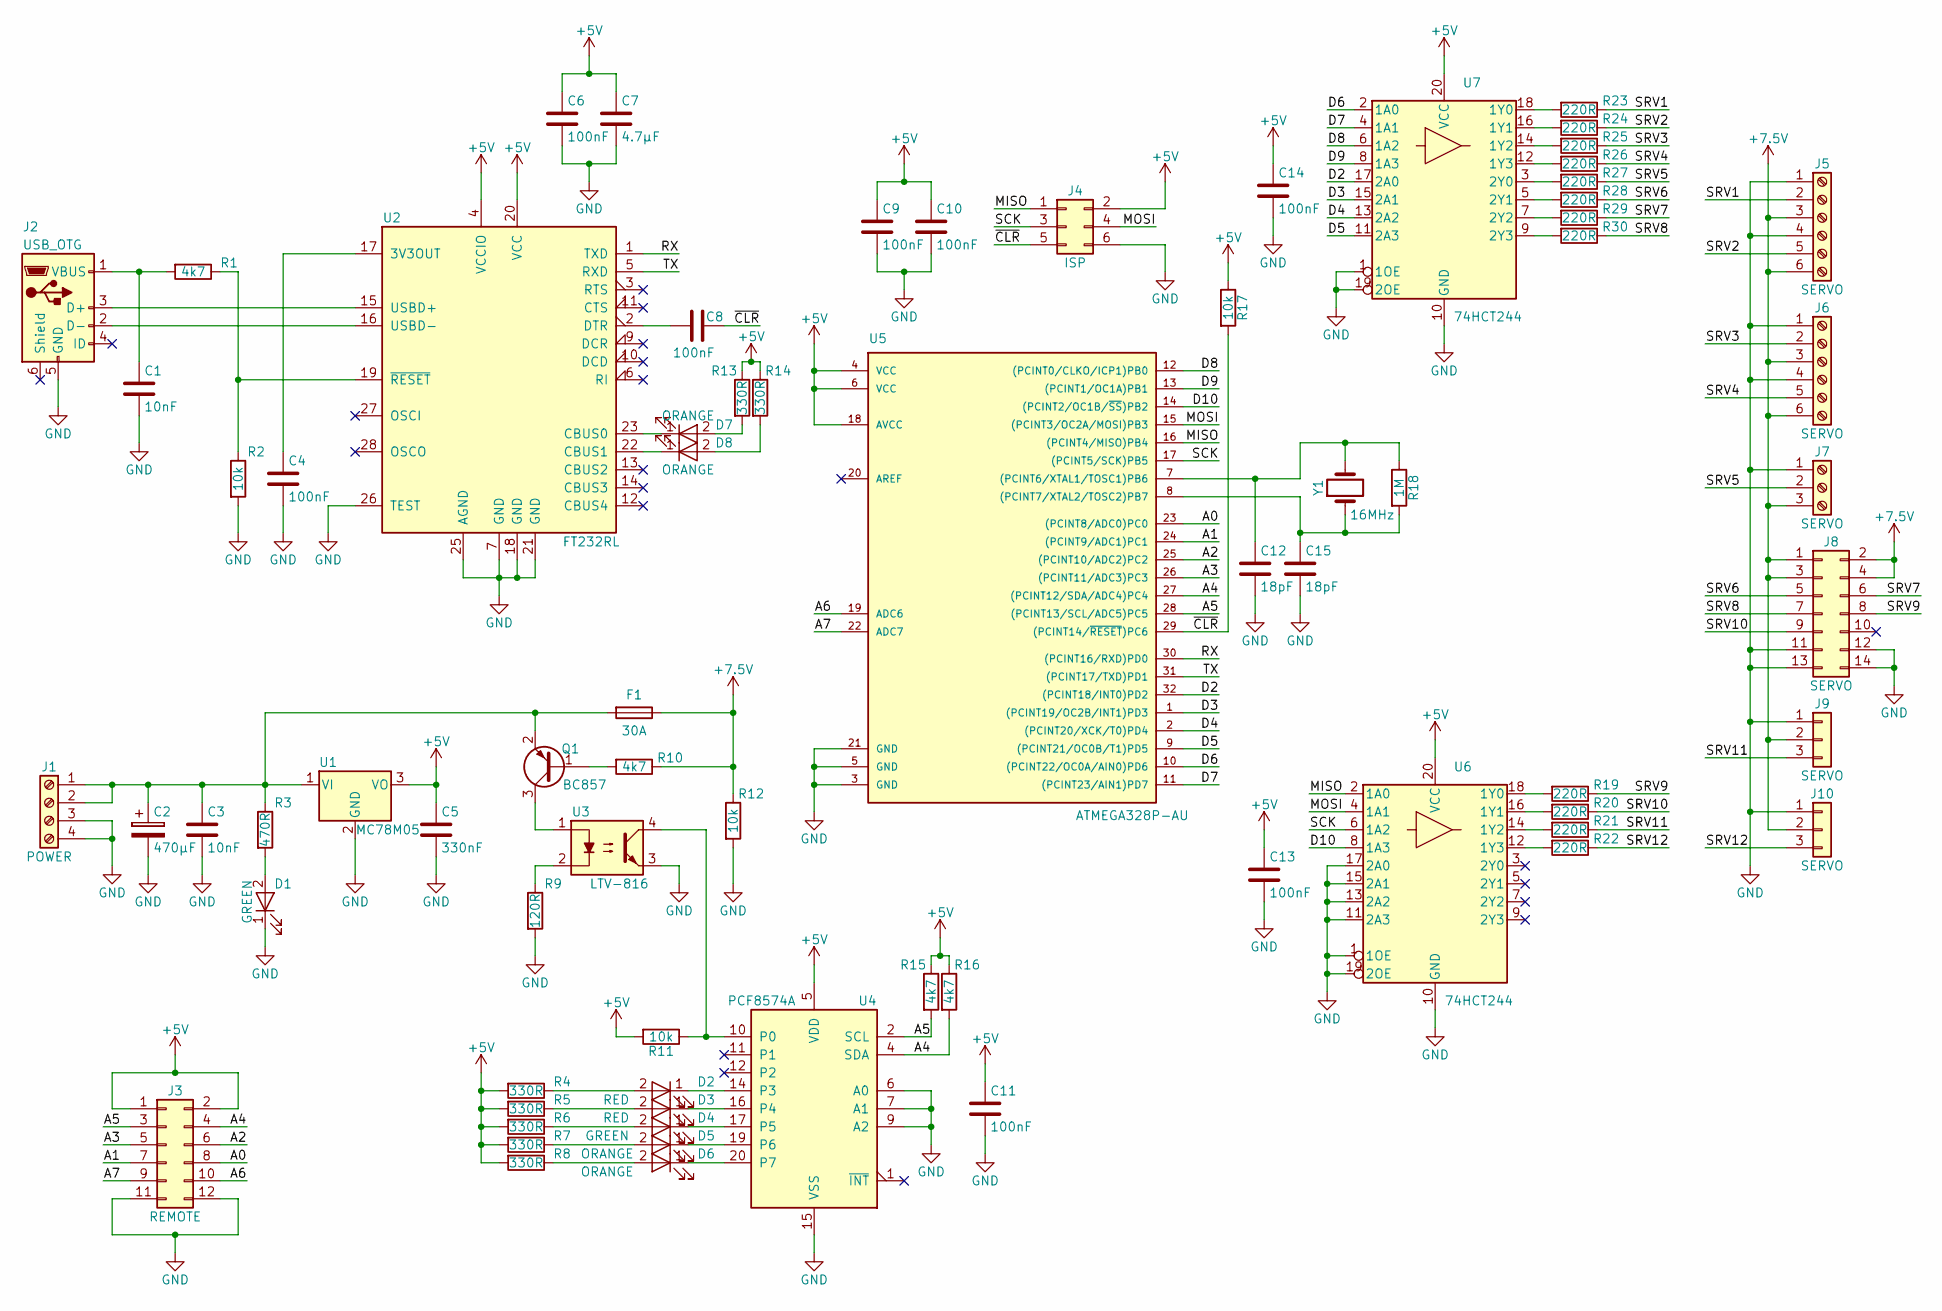
[picture p40: schematic high-torque-servo-arm-main.sch, High Torque Servo Arm: Main]

Parts:
C1, C3: 10nF; C_0805; Manufacturer Part Number C0805C103K1RACTU
C2: 470µF; CP_Elec_10x10.5; Manufacturer Part Number EEE-FC1A471P
C4, C6, C8, C9, C10, C11, C13, C14: 100nF; C_0805; Manufacturer Part Number C0805C104J5RACTU
C5: 330nF; C_0805; Manufacturer Part Number C0805C334K4RACTU
C7: 4.7µF; C_0805; Manufacturer Part Number C0805C475K8PACTU
C12, C15: 18pF; C_0805; Manufacturer Part Number C0805C180J5GAC
D1, D4: GREEN; LED_0805; Manufacturer Part Number LG R971-KN-1
D2, D3: RED; LED_0805; Manufacturer Part Number AP2012SRCPRV
D5, D6, D7, D8: ORANGE; LED_0805; Manufacturer Part Number LO R976-PS-1
F1: 30A; 3557; Manufacturer Part Number 3557-15
J1: POWER; 4DB-P108-04; Manufacturer Part Number 4DB-P108-04
J2: USB_OTG; USB_Mini-B; Manufacturer Part Number UJ2-MBH-1-SMT-TR
J3: REMOTE; IDC-Header_2x06_Pitch2.54mm_Straight; Manufacturer Part Number 70246-1201
J4: ISP; IDC-Header_2x03_Pitch2.54mm_Straight; Manufacturer Part Number 61200621621
J5, J6: SERVO; 1762075; Manufacturer Part Number 1762075
J7: SERVO; 1759020; Manufacturer Part Number 1759020
J8: SERVO; 61201422021; Manufacturer Part Number 61201422021
J9, J10: SERVO; Pin_Header_Straight_1x03_Pitch2.54mm; Manufacturer Part Number 22-28-9034
Q1: BC857; SOT-23; Manufacturer Part Number BC857CLT1G
R1, R10, R15, R16: 4k7; R_0805_HandSoldering; Manufacturer Part Number CR0805-JW-472ELF
R2, R11, R12, R17: 10k; R_0805_HandSoldering; Manufacturer Part Number CR0805-JW-103ELF
R3: 470R; R_0805_HandSoldering; Manufacturer Part Number CR0805-JW-471ELF
R4, R5, R6, R7, R8, R13, R14: 330R; R_0805_HandSoldering; Manufacturer Part Number CR0805-JW-331ELF
R9: 120R; R_0805_HandSoldering; Manufacturer Part Number CR0805-JW-121ELF
R18: 1M; R_0805_HandSoldering; Manufacturer Part Number CR0805-JW-105ELF
R19, R20, R21, R22, R23, R24, R25, R26, R27, R28, R29, R30: 220R; R_0805_HandSoldering; Manufacturer Part Number CR0805-JW-221ELF
U1: MC78M05; TO-252-2; Manufacturer Part Number MC78M05CDTRKG
U2: FT232RL; SSOP-28_5.3x10.2mm_Pitch0.65mm; Manufacturer Part Number FT232RL-REEL
U3: LTV-816; DIP-4_W8.89mm_SMDSocket_LongPads; Manufacturer Part Number LTV-816S
U4: PCF8574A; TSSOP-20_4.4x6.5mm_Pitch0.65mm; Manufacturer Part Number PCF8574APWRE4
U5: ATMEGA328P-AU; TQFP-32_7x7mm_Pitch0.8mm; Manufacturer Part Number ATMEGA328P-AU
U6, U7: 74HCT244; SSOP-20_5.3x7.2mm_Pitch0.65mm; Manufacturer Part Number SN74LV244ADBR
Y1: 16MHz; Crystal_SMD_HC49-SD; Manufacturer Part Number ABLS-16.000MHZ-B4-T

Connections:
+5V: C5.1, C6.1, C7.1, C9.1, C10.1, C11.1, C13.1, C14.1, J3.1, J3.2, J4.2, R4.2, R5.2, R6.2, R7.2, R8.2, R11.2, R13.1, R14.1, R15.1, R16.1, R17.1, U1.3 (VO), U2.4 (VCCIO), U2.20 (VCC), U4.5 (VDD), U5.4 (VCC), U5.6 (VCC), U5.18 (AVCC), U6.20 (VCC), U7.20 (VCC)
+7.5V: F1.1, J5.3, J5.6, J6.3, J6.6, J7.3, J8.1, J8.2, J8.3, J8.4, J9.2, J10.2, R10.1, R12.1
/A0: J3.8, U5.23 ((PCINT8/ADC0)PC0)
/A1: J3.7, U5.24 ((PCINT9/ADC1)PC1)
/A2: J3.6, U5.25 ((PCINT10/ADC2)PC2)
/A3: J3.5, U5.26 ((PCINT11/ADC3)PC3)
/A4: J3.4, R16.2, U4.4 (SDA), U5.27 ((PCINT12/SDA/ADC4)PC4)
/A5: J3.3, R15.2, U4.2 (SCL), U5.28 ((PCINT13/SCL/ADC5)PC5)
/A6: J3.10, U5.19 (ADC6)
/A7: J3.9, U5.22 (ADC7)
/D2: U5.32 ((PCINT18/INT0)PD2), U7.17 (2A0)
/D3: U5.1 ((PCINT19/OC2B/INT1)PD3), U7.15 (2A1)
/D4: U5.2 ((PCINT20/XCK/T0)PD4), U7.13 (2A2)
/D5: U5.9 ((PCINT21/OC0B/T1)PD5), U7.11 (2A3)
/D6: U5.10 ((PCINT22/OC0A/AIN0)PD6), U7.2 (1A0)
/D7: U5.11 ((PCINT23/AIN1)PD7), U7.4 (1A1)
/D8: U5.12 ((PCINT0/CLKO/ICP1)PB0), U7.6 (1A2)
/D9: U5.13 ((PCINT1/OC1A)PB1), U7.8 (1A3)
/D10: U5.14 ((PCINT2/OC1B/~SS~)PB2), U6.8 (1A3)
/MISO: J4.1, U5.16 ((PCINT4/MISO)PB4), U6.2 (1A0)
/MOSI: J4.4, U5.15 ((PCINT3/OC2A/MOSI)PB3), U6.4 (1A1)
/RX: U2.1 (TXD), U5.30 ((PCINT16/RXD)PD0)
/SCK: J4.3, U5.17 ((PCINT5/SCK)PB5), U6.6 (1A2)
/SRV1: J5.2, R23.1
/SRV2: J5.5, R24.1
/SRV3: J6.2, R25.1
/SRV4: J6.5, R26.1
/SRV5: J7.2, R27.1
/SRV6: J8.5, R28.1
/SRV7: J8.6, R29.1
/SRV8: J8.7, R30.1
/SRV9: J8.8, R19.1
/SRV10: J8.9, R20.1
/SRV11: J9.3, R21.1
/SRV12: J10.3, R22.1
/TX: U2.5 (RXD), U5.31 ((PCINT17/TXD)PD1)
/~CLR: C8.2, J4.5, R17.2, U5.29 ((PCINT14/~RESET~)PC6)
GND: C1.2, C2.2, C3.2, C4.2, C5.2, C6.2, C7.2, C9.2, C10.2, C11.2, C12.2, C13.2, C14.2, C15.2, D1.1 (K), J1.3, J1.4, J2.5 (GND), J3.11, J3.12, J4.6, J5.1, J5.4, J6.1, J6.4, J7.1, J8.11, J8.12, J8.13, J8.14, J9.1, J10.1, R2.2, R9.2, R12.2, U1.2 (GND), U2.7 (GND), U2.18 (GND), U2.21 (GND), U2.25 (AGND), U2.26 (TEST), U3.3, U4.6 (A0), U4.7 (A1), U4.9 (A2), U4.15 (VSS), U5.3 (GND), U5.5 (GND), U5.21 (GND), U6.1 (1OE), U6.10 (GND), U6.11 (2A3), U6.13 (2A2), U6.15 (2A1), U6.17 (2A0), U6.19 (2OE), U7.1 (1OE), U7.10 (GND), U7.19 (2OE)
unnamed: C1.1, J2.1 (VBUS), R1.2
unnamed: C2.1, C3.1, F1.2, J1.1, J1.2, Q1.2 (E), R3.1, U1.1 (VI)
unnamed: C4.1, U2.17 (3V3OUT)
unnamed: C8.1, U2.2 (DTR)
unnamed: C12.1, R18.1, U5.7 ((PCINT6/XTAL1/TOSC1)PB6), Y1.2
unnamed: C15.1, R18.2, U5.8 ((PCINT7/XTAL2/TOSC2)PB7), Y1.1
unnamed: D1.2 (A), R3.2
unnamed: D2.1 (K), U4.14 (P3)
unnamed: D2.2 (A), R4.1
unnamed: D3.1 (K), U4.16 (P4)
unnamed: D3.2 (A), R5.1
unnamed: D4.1 (K), U4.17 (P5)
unnamed: D4.2 (A), R6.1
unnamed: D5.1 (K), U4.19 (P6)
unnamed: D5.2 (A), R7.1
unnamed: D6.1 (K), U4.20 (P7)
unnamed: D6.2 (A), R8.1
unnamed: D7.1 (K), U2.23 (CBUS0)
unnamed: D7.2 (A), R13.2
unnamed: D8.1 (K), U2.22 (CBUS1)
unnamed: D8.2 (A), R14.2
unnamed: J2.2 (D-), U2.16 (USBD-)
unnamed: J2.3 (D+), U2.15 (USBD+)
unnamed: Q1.1 (B), R10.2
unnamed: Q1.3 (C), U3.1
unnamed: R1.1, R2.1, U2.19 (~RESET~)
unnamed: R9.1, U3.2
unnamed: R11.1, U3.4, U4.10 (P0)
unnamed: R19.2, U6.18 (1Y0)
unnamed: R20.2, U6.16 (1Y1)
unnamed: R21.2, U6.14 (1Y2)
unnamed: R22.2, U6.12 (1Y3)
unnamed: R23.2, U7.18 (1Y0)
unnamed: R24.2, U7.16 (1Y1)
unnamed: R25.2, U7.14 (1Y2)
unnamed: R26.2, U7.12 (1Y3)
unnamed: R27.2, U7.3 (2Y0)
unnamed: R28.2, U7.5 (2Y1)
unnamed: R29.2, U7.7 (2Y2)
unnamed: R30.2, U7.9 (2Y3)
unnamed: U4.3 (NC), U4.8 (NC), U4.13 (NC), U4.18 (NC)

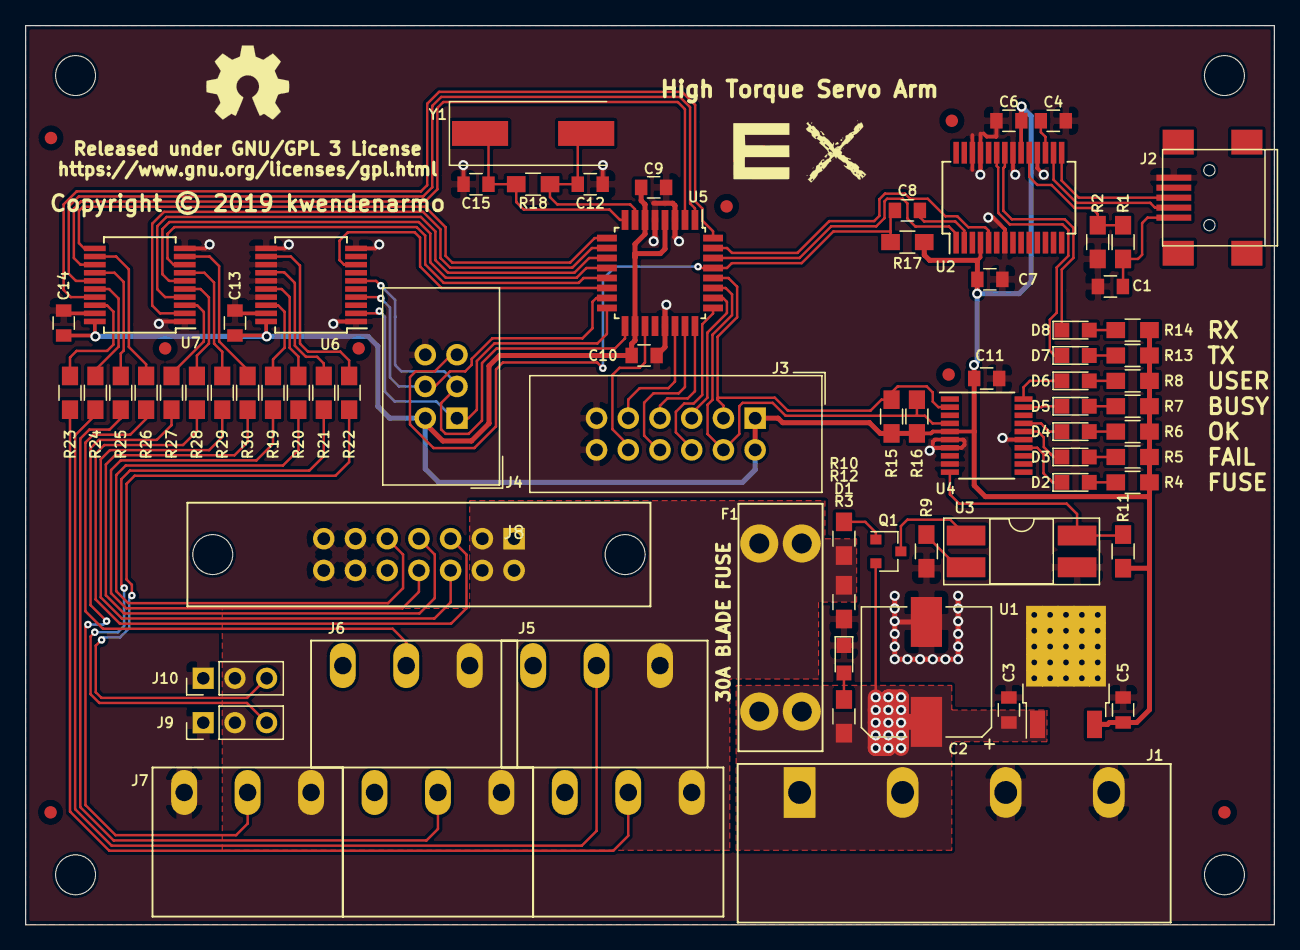
[picture p41: board high-torque-servo-arm-main.kicad_pcb from above]

Board: 2 copper layers, 100.0 x 72.0 mm, 73 parts (0 on the bottom side), 79 nets.
