akornsys-rdi/high-torque-servo-arm/brd/remote/high-torque-servo-arm-remote.kicad_pcb

## KiCad design brd/remote/high-torque-servo-arm-remote.kicad_pcb (2020-02-25)

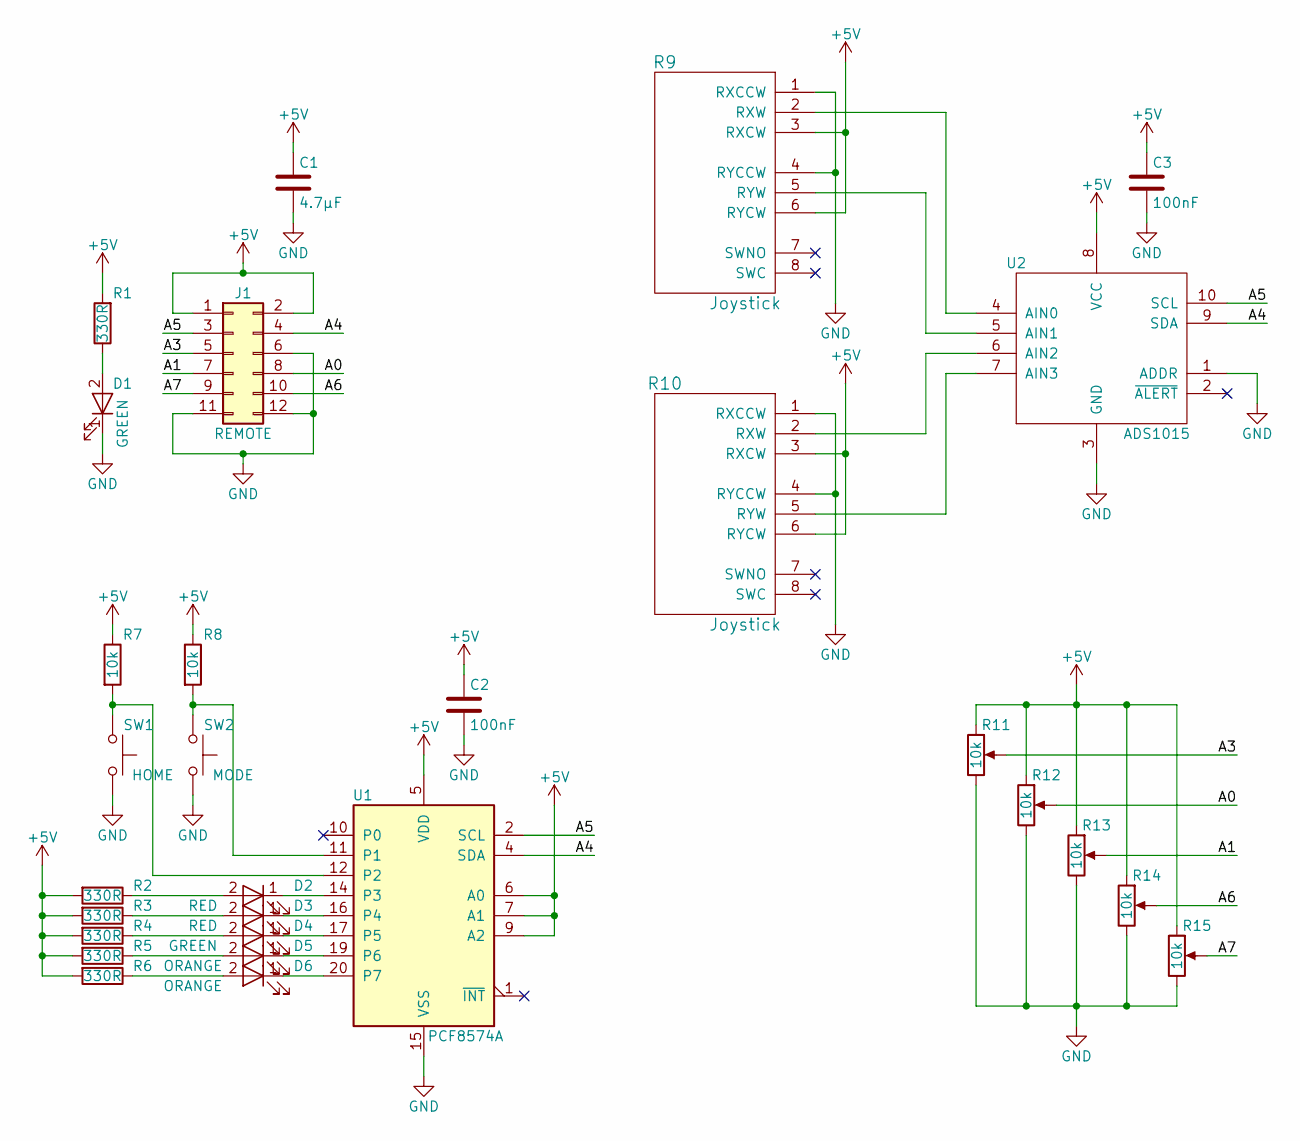
[picture p42: schematic high-torque-servo-arm-remote.sch]

Parts:
C1: 4.7µF; C_0805; Manufacturer Part Number C0805C475K8PACTU
C2, C3: 100nF; C_0805; Manufacturer Part Number C0805C104J5RACTU
D1, D4: GREEN; LED_0805_HandSoldering; Manufacturer Part Number LG R971-KN-1
D2, D3: RED; LED_0805_HandSoldering; Manufacturer Part Number AP2012SRCPRV
D5, D6: ORANGE; LED_0805_HandSoldering; Manufacturer Part Number LO R976-PS-1
J1: REMOTE; IDC-Header_2x06_Pitch2.54mm_Straight; Manufacturer Part Number 70246-1201
R1, R2, R3, R4, R5, R6: 330R; R_0805_HandSoldering; Manufacturer Part Number CR0805-JW-331ELF
R7, R8: 10k; R_0805_HandSoldering; Manufacturer Part Number CR0805-JW-103ELF
R9, R10: Joystick; 311110005; Manufacturer Part Number 311110005
R11, R12, R13, R14, R15: 10k; RS08U111Z001; Manufacturer Part Number RS08U111Z001
SW1: HOME; SW_PUSH_6mm_h4.3mm; Manufacturer Part Number FSM4JH
SW2: MODE; SW_PUSH_6mm_h4.3mm; Manufacturer Part Number FSM4JH
U1: PCF8574A; TSSOP-20_4.4x6.5mm_Pitch0.65mm; Manufacturer Part Number PCF8574APWRE4
U2: ADS1015; MSOP-10_3x3mm_Pitch0.5mm; Manufacturer Part Number ADS1015IDGSR

Connections:
+5V: C1.1, C2.1, C3.1, J1.1, J1.2, R1.2, R2.2, R3.2, R4.2, R5.2, R6.2, R7.1, R8.1, R9.3 (RXCW), R9.6 (RYCW), R10.3 (RXCW), R10.6 (RYCW), R11.1, R12.1, R13.1, R14.1, R15.1, U1.5 (VDD), U1.6 (A0), U1.7 (A1), U1.9 (A2), U2.8 (VCC)
/A0: J1.8, R12.2
/A1: J1.7, R13.2
/A3: J1.5, R11.2
/A4: J1.4, U1.4 (SDA), U2.9 (SDA)
/A5: J1.3, U1.2 (SCL), U2.10 (SCL)
/A6: J1.10, R14.2
/A7: J1.9, R15.2
GND: C1.2, C2.2, C3.2, D1.1 (K), J1.6, J1.11, J1.12, R9.1 (RXCCW), R9.4 (RYCCW), R10.1 (RXCCW), R10.4 (RYCCW), R11.3, R12.3, R13.3, R14.3, R15.3, SW1.2, SW2.2, U1.15 (VSS), U2.1 (ADDR), U2.3 (GND)
unnamed: D1.2 (A), R1.1
unnamed: D2.1 (K), U1.14 (P3)
unnamed: D2.2 (A), R2.1
unnamed: D3.1 (K), U1.16 (P4)
unnamed: D3.2 (A), R3.1
unnamed: D4.1 (K), U1.17 (P5)
unnamed: D4.2 (A), R4.1
unnamed: D5.1 (K), U1.19 (P6)
unnamed: D5.2 (A), R5.1
unnamed: D6.1 (K), U1.20 (P7)
unnamed: D6.2 (A), R6.1
unnamed: R7.2, SW1.1, U1.12 (P2)
unnamed: R8.2, SW2.1, U1.11 (P1)
unnamed: R9.2 (RXW), U2.4 (AIN0)
unnamed: R9.5 (RYW), U2.5 (AIN1)
unnamed: R10.2 (RXW), U2.6 (AIN2)
unnamed: R10.5 (RYW), U2.7 (AIN3)
unnamed: U1.3 (NC), U1.8 (NC), U1.13 (NC), U1.18 (NC)

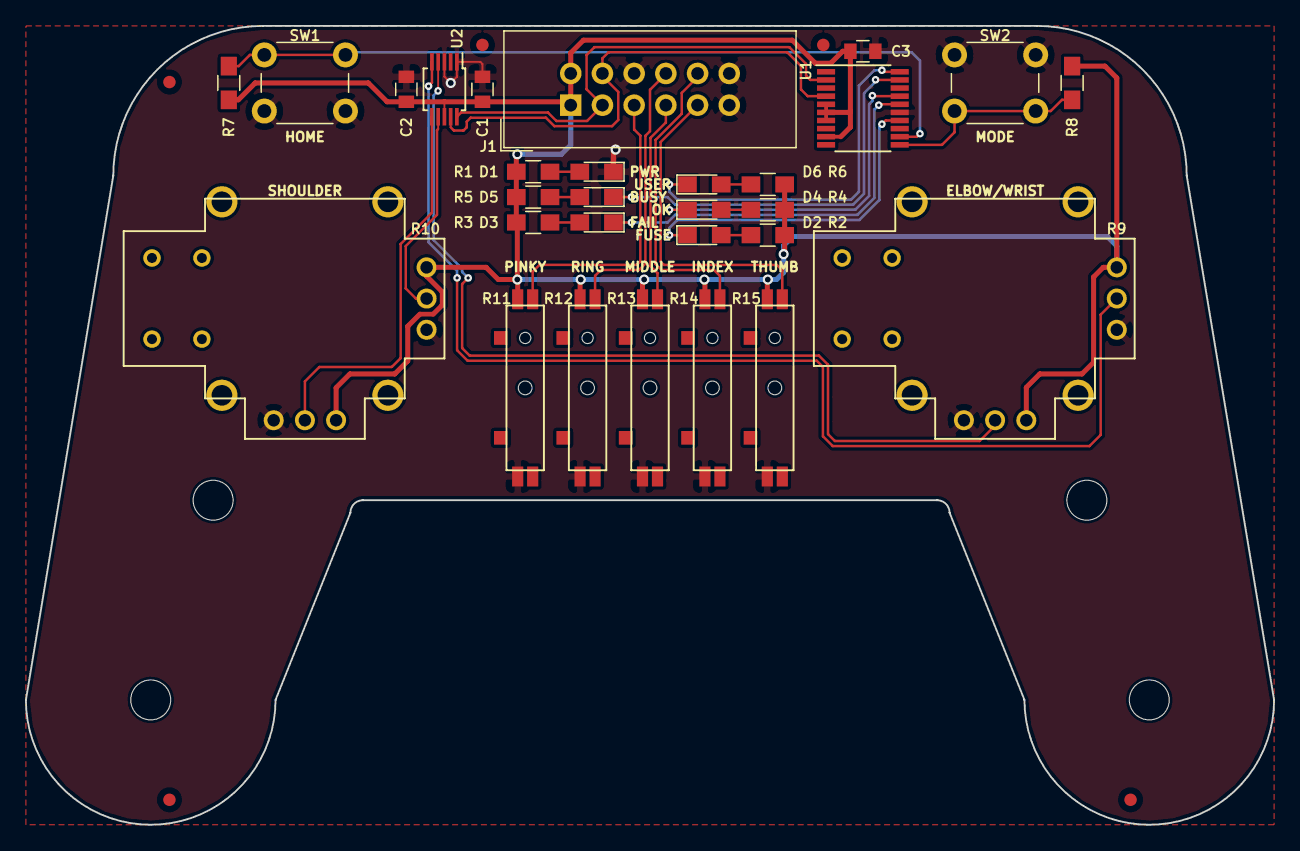
[picture p43: board high-torque-servo-arm-remote.kicad_pcb from above]

Board: 2 copper layers, 100.0 x 64.0 mm, 29 parts (0 on the bottom side), 27 nets.
