akornsys-rdi/high-torque-servo-arm/brd/microservo/high-torque-servo-arm-microservo.kicad_pcb

## KiCad design brd/microservo/high-torque-servo-arm-microservo.kicad_pcb (2019-12-08)

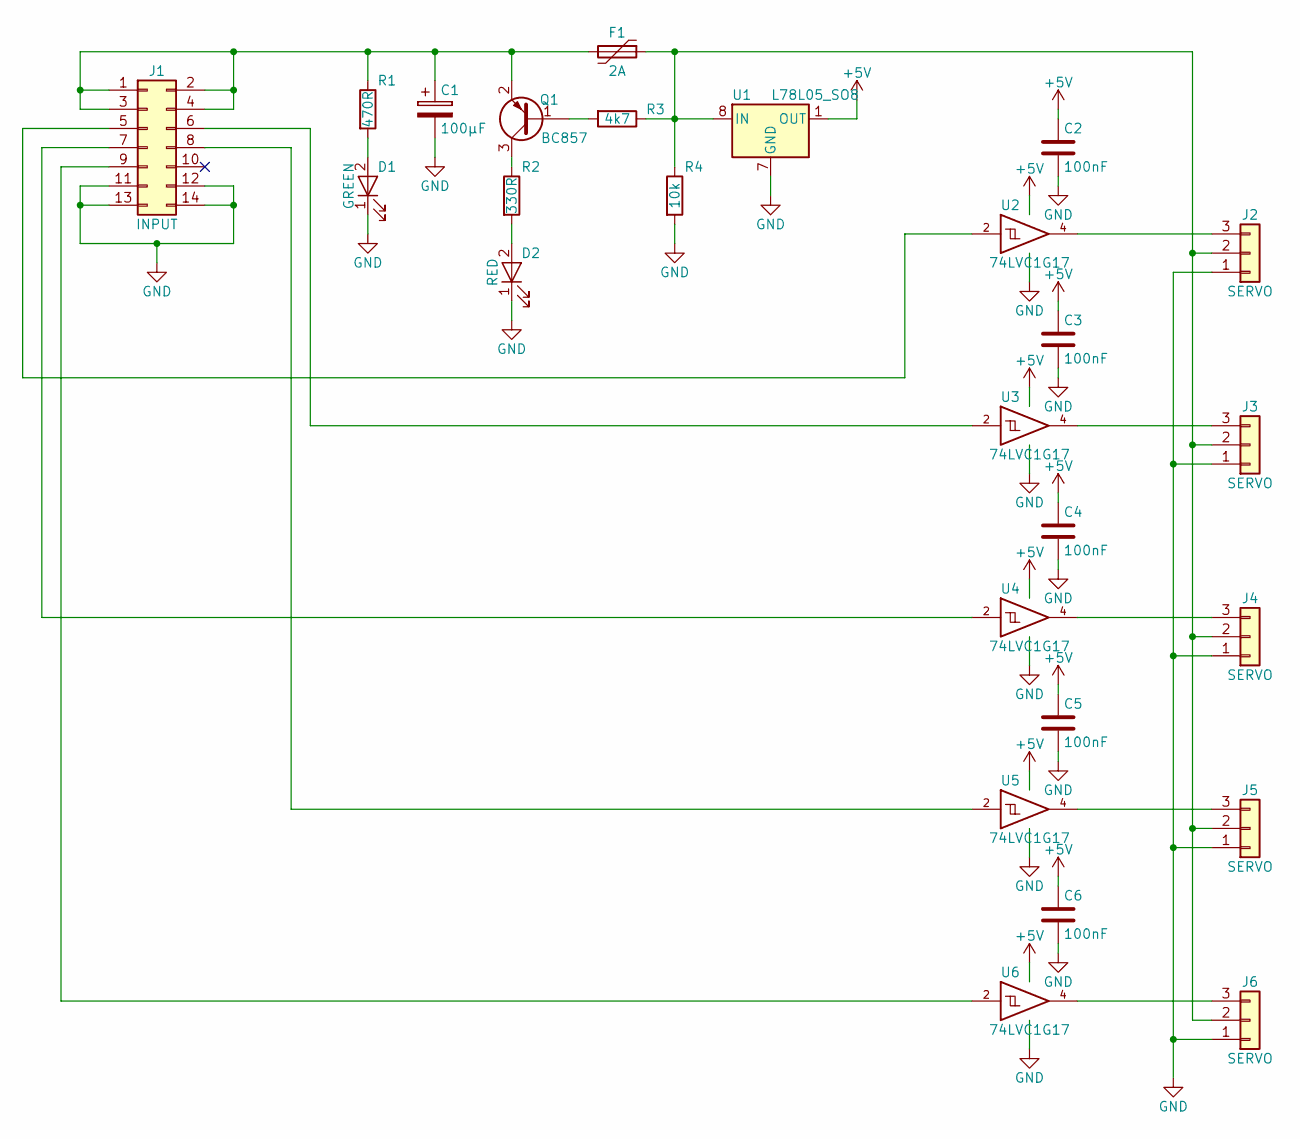
[picture p44: schematic high-torque-servo-arm-microservo.sch, High Torque Servo Arm: Microservo]

Parts:
C1: 100µF; CP_Elec_6.3x7.7; Manufacturer Part Number EEE-HC1C101XP
C2, C3, C4, C5, C6: 100nF; C_0805; Manufacturer Part Number C0805C104J5RACTU
D1: GREEN; LED_0805; Manufacturer Part Number LG R971-KN-1
D2: RED; LED_0805; Manufacturer Part Number AP2012SRCPRV
F1: 2A; Fuse_SMD2920; Manufacturer Part Number 0ZCF0200FF2C
J1: INPUT; 61201422021; Manufacturer Part Number 61201422021
J2, J3, J4, J5, J6: SERVO; Pin_Header_Angled_1x03_Pitch2.54mm; Manufacturer Part Number 22-28-9034
Q1: BC857; SOT-23; Manufacturer Part Number BC857CLT1G
R1: 470R; R_0805_HandSoldering; Manufacturer Part Number CR0805-JW-471ELF
R2: 330R; R_0805_HandSoldering; Manufacturer Part Number CR0805-JW-331ELF
R3: 4k7; R_0805_HandSoldering; Manufacturer Part Number CR0805-JW-472ELF
R4: 10k; R_0805_HandSoldering; Manufacturer Part Number CR0805-JW-103ELF
U1: L78L05_SO8; SOIC-8_3.9x4.9mm_Pitch1.27mm; Manufacturer Part Number L78L05ABD13TR
U2, U3, U4, U5, U6: 74LVC1G17; SOT-23-5; Manufacturer Part Number SN74LVC1G17DBVR

Connections:
+5V: C2.1, C3.1, C4.1, C5.1, C6.1, U1.1 (OUT), U2.5 (VCC), U3.5 (VCC), U4.5 (VCC), U5.5 (VCC), U6.5 (VCC)
GND: C1.2, C2.2, C3.2, C4.2, C5.2, C6.2, D1.1 (K), D2.1 (K), J1.11, J1.12, J1.13, J1.14, J2.1, J3.1, J4.1, J5.1, J6.1, R4.2, U1.2 (GND), U1.3 (GND), U1.6 (GND), U1.7 (GND), U2.3 (GND), U3.3 (GND), U4.3 (GND), U5.3 (GND), U6.3 (GND)
unnamed: C1.1, F1.2, J1.1, J1.2, J1.3, J1.4, Q1.2 (E), R1.1
unnamed: D1.2 (A), R1.2
unnamed: D2.2 (A), R2.2
unnamed: F1.1, J2.2, J3.2, J4.2, J5.2, J6.2, R3.1, R4.1, U1.8 (IN)
unnamed: J1.5, U2.2
unnamed: J1.6, U3.2
unnamed: J1.7, U4.2
unnamed: J1.8, U5.2
unnamed: J1.9, U6.2
unnamed: J2.3, U2.4
unnamed: J3.3, U3.4
unnamed: J4.3, U4.4
unnamed: J5.3, U5.4
unnamed: J6.3, U6.4
unnamed: Q1.1 (B), R3.2
unnamed: Q1.3 (C), R2.1

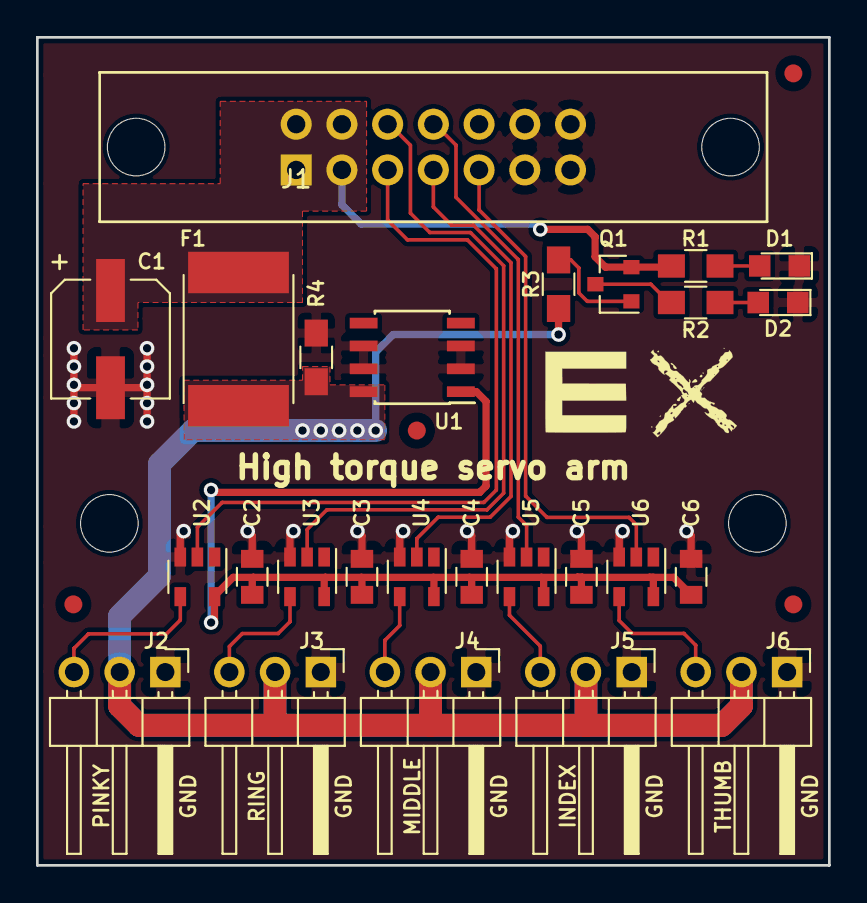
[picture p45: board high-torque-servo-arm-microservo.kicad_pcb from above]

Board: 2 copper layers, 44.0 x 46.0 mm, 26 parts (0 on the bottom side), 18 nets.
