akornsys-rdi/high-torque-servo-arm/(commit log)

2019-12-06 añadido diseño de pcb servo
    [high-torque-servo-arm-servo.kicad_pcb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]
2019-12-06 añadido diseño de pcb microservo
    [high-torque-servo-arm-microservo.kicad_pcb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]
2019-12-08 corregido tamaño de taladro en huella
    [high-torque-servo-arm-microservo.kicad_pcb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]
2019-12-08 añadido diseño de pcb main
    [high-torque-servo-arm-main.kicad_pcb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]
2020-02-25 actualizado diseño de pcb y añadida remote
    [high-torque-servo-arm-main.kicad_pcb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]
2020-02-25 subido códigos de autotest
2020-02-25 subidos archivos 3d
    [Auriculaire3.stl, Bolt_entretoise7.stl, Index3.stl, Majeure3.stl, WristlargeV4.stl, WristsmallV3.stl, elbow-axis-clip.stl, elbow-axis-small.stl]
2020-02-26 añadido código de control principal
