akornsys-rdi/high-torque-servo-arm/(notices)

Notices in the files:
brd/remote/high-torque-servo-arm-remote.kicad_pcb:
Released under GNU/GPL 3 License
https://www.gnu.org/licenses/gpl.html
Copyright © 2019 kwendenarmo
